moddoio/moddoMOUSE-PCB/Images/Pinout/PCB.png

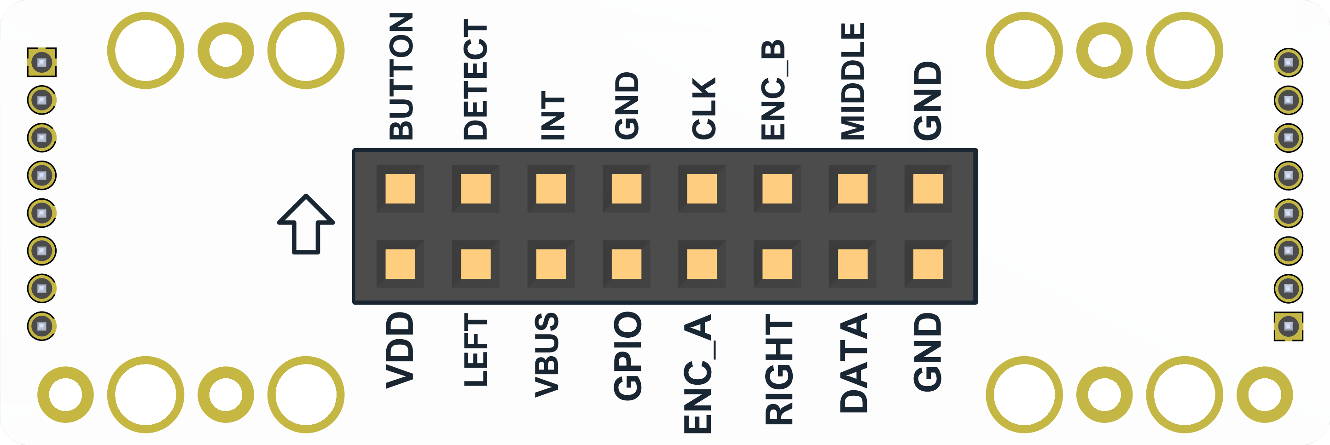
Images/Pinout/PCB.png
