moddoio/moddoMOUSE-PCB/Back_Breakout/Release/PCBA/02.BOM/Bill_Of_Materials-BoM.xlsx

Designator | Name | Description | Manufacturer Part Number | Manufacturer | Footprint | Quantity | Fitted | RoHS Status | Supplier Link
J1, J2 | 1.27mm_6pins |  |  |  | 1.27mm_6pins_MaleHeader_RightAngle | 2 | Fitted | Yes
P1 | Header 6X2 | Header, 6-Pin, Dual row | RS2-12-G | Adam Tech | HEADER_2_54_F_2X6 | 1 | Fitted | ROHS3 | https://www.digikey.ca/en/products/detail/adam-tech/RS2-12-G/9832053
