moddoio/moddoMOUSE-PCB/Back_Lite/Release/PCBA/02.BOM/Bill_Of_Materials-BoM.xlsx

Designator | Name | Description | Manufacturer Part Number | Manufacturer | Footprint | Quantity | Fitted | RoHS Status | Supplier Link
J1 | 1.27mm_6pins | Pin Header 6 Position 1.27mm Pitch Single Row Through Hole, Right Angle -40℃~+105℃ | 1271WR-6P | HanElectricity | 1.27mm_6pins_MaleHeader_RightAngle | 1 | Fitted | Yes | https://www.lcsc.com/product-detail/C7470100.html
J2 | 2328702-8 | FFC/FPC Connector, 8 Contact(s), 1 Row(s), Right Angle, Solder Terminal, Natural Insulator | 2328702-8 | TE Connectivity | 2328702-8 | 1 | Fitted | Yes | https://www.digikey.ca/en/products/detail/te-connectivity-amp-connectors/2328702-8/9565576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
