moddoio/moddoMOUSE-PCB/Front_Breakout/Release/PCBA/02.BOM/Bill_Of_Materials-BoM.xlsx

Designator | Name | Description | Manufacturer Part Number | Manufacturer | Footprint | Quantity | Fitted | RoHS Status | Supplier Link
J1, J2 | 1.27mm_8pins |  |  |  | 1.27mm_8pins_MaleHeader | 2 | Fitted | Yes
P1 | Header 8X2 | Header, 8-Pin, Dual row | RS2-16-G | Adam Tech | HEADER_2_54_F_2X8 | 1 | Fitted | Yes | https://www.digikey.ca/en/products/detail/adam-tech/RS2-16-G/9832058
