moddoio/moddoMOUSE-PCB/Front_Default/Release/PCBA/02.BOM/Bill_Of_Materials-BoM(Main).xlsx

Designator | Name | Description | Manufacturer Part Number | Manufacturer | Footprint | Quantity | Fitted | RoHS Status | Supplier Link
C1, C2, C3, C4, C5 | N/A | N/A | N/A | N/A | CAP0603 | 0 | Not Fitted | Yes | N/A
EN1 | EC10E1220501 | Rotary Encoder Mechanical 12 Quadrature (Incremental) Vertical | EC10E1220501 | Alps Alpine | THROUGH_SHAFT_ENCODER_9MM | 1 | Fitted | ROHS3 | https://www.digikey.ca/en/products/detail/alps-alpine/EC10E1220501/21721562
J1, J2 | 1.27mm_8pins | 1.27mm 1.27mm 1A 1 Gold -40℃~+105℃ 8P Phosphor Bronze Through Hole 1x8P Top 4.3mm Square Hole Through Hole,P=1.27mm Female Headers ROHS |  |  | HEADER_MALE_1_27mm_8p_HEIGHT_1mm | 2 | Fitted | Yes
R1, R2, R3, R4, R5 | N/A | N/A | N/A | N/A | RES0603 | 0 | Not Fitted | Yes | N/A
SW1, SW3 | D2F-01F | SWITCH SNAP ACTION SPDT 0.1A 30V | D2F-01F | Omron Electronics Inc-EMC Div | Microswitch | 2 | Fitted | Yes | https://www.digikey.ca/en/products/detail/omron-electronics-inc-emc-div/D2F-01F/83266
SW2 | TS02-66-70-BK-100-SCR-D | Switch Tactile Spst-no 0.05A 12V | TS02-66-70-BK-100-SCR-D | Same Sky | TS02-66-70-BK-100-SCR-D | 1 | Fitted | Yes | https://www.digikey.ca/en/products/detail/same-sky-formerly-cui-devices/TS02-66-70-BK-100-SCR-D/15634293
