moddoio/moddoMOUSE-PCB/Side_Lite/Release/PCBA/02.BOM/Bill_Of_Materials-BoM.xlsx

Designator | Name | Description | Manufacturer Part Number | Manufacturer | Footprint | Quantity | Fitted | RoHS Status | Supplier Link
J1 | 2328702-8 | FFC/FPC Connector, 8 Contact(s), 1 Row(s), Right Angle, Solder Terminal, Natural Insulator | 2328702-8 | TE Connectivity | 2328702-8 | 1 | Fitted | Yes | https://www.lcsc.com/product-detail/C3168593.html?s_z=n_2328702-8
SW1, SW2 | D2F-01F | SWITCH SNAP ACTION SPDT 0.1A 30V | D2F-01F | Omron Electronics Inc-EMC Div | Microswitch | 2 | Fitted
