moddoio/moddoMOUSE-PCB/Back_Expansion/Back_Expansion_Base/Release/PCBA/02.BOM/Bill_Of_Materials-BoM(Main).xlsx

Designator | Name | Description | Manufacturer Part Number | Manufacturer | Footprint | Quantity | Fitted | RoHS Status | Supplier Link
C1, C4, C6, C7, C8 | 10uF | 25V 10uF X5R ±10% 0603 Multilayer Ceramic Capacitors MLCC - SMD/SMT ROHS | GRM188R61E106KA73D | Murata | C0603 | 5 | Fitted | Yes | https://www.digikey.ca/en/products/detail/murata-electronics/GRM188R61E106KA73D/9867922
C2, C3, C5, C9, C10 | 0.1uF | 25V 100nF X7R ±10% 0402 Multilayer Ceramic Capacitors MLCC - SMD/SMT ROHS | CL05B104KA5NNNC | Samsung Electro-Mechanics | C0402 | 5 | Fitted | Yes | https://www.digikey.ca/en/products/detail/samsung-electro-mechanics/CL05B104KA5NNNC/5961204
D1 | MMDL770T1G | Schottky Barrier Diode, 2-Pin SOD-323, Pb-Free, Tape and Reel | MMDL770T1G | On Semiconductor | ONSC-SOD-323-2-477-02_V | 1 | Fitted | Yes | https://www.digikey.ca/en/products/detail/onsemi/MMDL770T1G/1482073
D2 | LTST-C191KGKT | Single Color LED, Ultra Bright Green, Water Clear, 1.1mm | LTST-C191KGKT | Lite-On | LED0603_G | 1 | Fitted | Yes | https://www.digikey.ca/en/products/detail/liteon/LTST-C191KGKT/386835
J1 | 12402012E212A | USB Connector, USB Type C, USB 2.0, Receptacle, 24 Ways, Surface Mount, Through Hole Mount | 12402012E212A | Amphenol | 12402012E212A | 1 | Fitted | Yes | https://www.digikey.ca/en/products/detail/amphenol-cs-commercial-products/12402012E212A/13683192
J2, J3 | 1271WR-6P | Pin Header 6 Position 1.27mm Pitch Single Row Through Hole, Right Angle -40℃~+105℃ | 1271WR-6P | HanElectricity | 1.27mm_6pins_MaleHeader_RightAngle | 2 | Fitted | Yes | https://www.lcsc.com/product-detail/C7470100.html
J4, J5, J6, J7, J8 | 2328702-8 | FFC/FPC Connector, 8 Contact(s), 1 Row(s), Right Angle, Solder Terminal, Natural Insulator | 2328702-8 | TE Connectivity | 2328702-8 | 5 | Fitted | Yes | https://www.digikey.ca/en/products/detail/te-connectivity-amp-connectors/2328702-8/9565576
LED1 | B38G3RGB-10D0003H2U1930 | Led Rgb Mixed White ( 1.6(L)X1.6 | B38G3RGB-10D0003H2U1930 | Inolux | B38G3RGB-10D0003H2U1930 | 1 | Fitted | Yes | https://www.digikey.ca/en/products/detail/harvatek-corporation/B38G3RGB-10D0003H2U1930/13588733
P1 | Header 5 | Header, 5-Pin | N/A | N/A | HDR1X5 | 0 | Not Fitted | N/A | N/A
P2, P4 | Header 4 | Header, 4-Pin | N/A | N/A | HDR1X4 | 0 | Not Fitted | N/A | N/A
P3 | Header 3X2 | Header, 3-Pin, Dual row | N/A | N/A | HDR2X3 | 0 | Not Fitted | N/A | N/A
Q1, Q2 | SSM6N35AFE,LF | Small Low ON Resistance MOSFET Array Dual N-Channel 20V 250mA 6-Pin SOT-563 T/R | SSM6N35AFE,LF | Toshiba | SSM6N35AFE,LF | 2 | Fitted | Yes | https://www.digikey.ca/en/products/detail/toshiba-semiconductor-and-storage/SSM6N35AFE-LF/7669724
Q3 | IRLML6402TRPBF | MOSFET P-CH 20V 3.7A SOT-23 | IRLML6402TRPBF | Infineon | IRLML6402TRPBF | 1 | Fitted | Yes | https://www.digikey.ca/en/products/detail/infineon-technologies/IRLML6402TRPBF/811437
R1, R2 | 5.1kR | 62.5mW Thick Film Resistors 50V ±100ppm/℃ ±1% 5.1kΩ 0402 Chip Resistor - Surface Mount ROHS | RC0402FR-075K1L | Yageo Group | R0402 | 2 | Fitted | Yes | https://www.digikey.ca/en/products/detail/yageo/RC0402FR-075K1L/726624
R3 | 390R | Res Thick Film 1206 390 Ohm 1% 0.75W(3/4W) ±100ppm/°C Pad SMD Automotive T/R | CRCW1206390RFKEAHP | Vishay | R1206 | 1 | Fitted | Yes | https://www.digikey.ca/en/products/detail/vishay-dale/CRCW1206390RFKEAHP/2227707
R4 | 33R | Res Thick Film Array 33 Ohm 5% 200ppm/ C ISOL Molded 8-Pin 1206(4 X 0603) Convex SMD Paper T/R | YC164-JR-0733RL | Yageo | YC164-JR-0733RL | 1 | Fitted | Yes | https://www.digikey.ca/en/products/detail/yageo/YC164-JR-0733RL/1005086
R5 | 115kR | 62.5mW Thick Film Resistors 50V ±100ppm/℃ ±1% 115kΩ 0402 Chip Resistor - Surface Mount ROHS | RC0402FR-07115KL | Yageo Group | R0402 | 0 | Not Fitted | Yes | https://www.digikey.ca/en/products/detail/yageo/RC0402FR-07115KL/5280816
SW1 | B3U-1100P | SWITCH TACTILE SPST-NO 0.05A 12V | B3U-1100P | Omron Electronics Inc-EMC Div | FP-B3U-1100P-MFG | 1 | Fitted | Yes | https://www.digikey.ca/en/products/detail/omron-electronics-inc-emc-div/B3U-1100P/1534339
U1 | ESDR0502NMUTBG | Ultra Low Capacitance ESD Protection Array for High Speed Data Line Protection, 6-Pin UDFN, Pb-Free, Tape and Reel | ESDR0502NMUTBG | On Semiconductor | ESDR0502NMUTBG | 1 | Fitted | Yes | https://www.digikey.ca/en/products/detail/onsemi/ESDR0502NMUTBG/2271457
U2 | TPS7A2030PDBVR | 300-mA, ultra-low-noise, low-IQ, low-dropout (LDO) linear regulator with high PSRR 5-SOT-23 -40 to 125 | TPS7A2030PDBVR | Texas Instruments | TPS7A2030PDBVR | 1 | Fitted | Yes | https://www.digikey.ca/en/products/detail/texas-instruments/TPS7A2030PDBVR/13566871
U3 | ATSAMD21G18A-MU | MCU 32-Bit SAM D21 ARM Cortex M0+ RISC 256KB Flash 3.3V 48-Pin QFN EP - Trays | ATSAMD21G18A-MU | Microchip | FP-C04-21493-MFG | 1 | Fitted | Yes | https://www.digikey.ca/en/products/detail/microchip-technology/ATSAMD21G18A-MU/4935894
