moddoio/moddoMOUSE-PCB/Back_Expansion/Back_Expansion_Joystick_14p_25_5mm_20_3mm/Release/PCBA/02.BOM/Bill_Of_Materials-BoM.xlsx

Designator | Name | Description | Manufacturer Part Number | Manufacturer | Footprint | Quantity | Fitted | RoHS Status | Supplier Link
J1 | 2328702-8 | FFC/FPC Connector, 8 Contact(s), 1 Row(s), Right Angle, Solder Terminal, Natural Insulator | 2328702-8 | TE Connectivity | 2328702-8 | 1 | Fitted | Yes | https://www.digikey.ca/en/products/detail/te-connectivity-amp-connectors/2328702-8/9565576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
SW1 | YK16S-L7.2-B10Ka(32-8)-G-A29 | Through Hole-14P,25.5x20.3mm Navigation Switches, Joystick RoHS | YK16S-L7.2-B10Ka(32-8)-G-A29 | YTL | Joystick_14p_25_5mm_20_3mm | 1 | Fitted | Yes | https://www.lcsc.com/product-detail/C37323746.html
