moddoio/moddoMOUSE-PCB/Back_Expansion/Back_Expansion_Joystick_8p_16_5mm_15_5mm/Release/PCBA/02.BOM/Bill_Of_Materials-BoM.xlsx

Designator | Name | Description | Manufacturer Part Number | Manufacturer | Footprint | Quantity | Fitted | RoHS Status | Supplier Link
J1 | 2328702-8 | FFC/FPC Connector, 8 Contact(s), 1 Row(s), Right Angle, Solder Terminal, Natural Insulator | 2328702-8 | TE Connectivity | 2328702-8 | 1 | Fitted | Yes | https://www.digikey.ca/en/products/detail/te-connectivity-amp-connectors/2328702-8/9565576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
SW1 | YHE-YG16-001 SH1B166A1 | Through Hole Navigation Switches, Joystick RoHS | YHE-YG16-001 SH1B166A1 | YTL | Joystick_8p_16_5mm_15_5mm | 1 | Fitted | Yes | https://www.lcsc.com/product-detail/C42411044.html
