moddoio/moddoMOUSE-PCB/Back_Expansion/Back_Expansion_Keypad_12/Release/PCBA/02.BOM/Bill_Of_Materials-BoM.xlsx

Designator | Name | Description | Manufacturer Part Number | Manufacturer | Footprint | Quantity | Fitted | RoHS Status | Supplier Link
J1, J2 | 2328702-8 | FFC/FPC Connector, 8 Contact(s), 1 Row(s), Right Angle, Solder Terminal, Natural Insulator | 2328702-8 | TE Connectivity | 2328702-8 | 2 | Fitted | Yes | https://www.digikey.ca/en/products/detail/te-connectivity-amp-connectors/2328702-8/9565576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
SW0, SW1, SW2, SW3, SW4, SW5, SW6, SW7, SW8, SW9, SW10, SW11 | GT-TS090C-H031-L5 | Tactile Switch SPST 100gf 3.1mm SMD (SMT) Tab 6.2mm x 6.2mm Surface Mount | GT-TS090C-H031-L5 | G-Switch | Switch_6_2mm_6_2mm_3_1mm | 12 | Fitted | Yes | https://www.lcsc.com/product-detail/C2686883.html?s_z=n_q_GT-TS090C-H031-L5
