moddoio/moddoMOUSE-PCB/Back_Expansion/Back_Expansion_ScrollWheel/Release/PCBA/02.BOM/Bill_Of_Materials-BoM(Main).xlsx

Designator | Name | Description | Manufacturer Part Number | Manufacturer | Footprint | Quantity | Fitted | RoHS Status | Supplier Link
EN1 | EC10E1220501 | Mechanical Encoder Rotary Incremental Hollow 5mN.m Right Angle Quadrature Digital Square Wave 12PPR Through Hole PC Pin | EC10E1220501 | Alps Electric | THROUGH_SHAFT_ENCODER_9MM | 1 | Fitted | Yes | https://www.digikey.ca/en/products/detail/alps-alpine/EC10E1220501/21721562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
J1 | 2328702-8 | FFC/FPC Connector, 8 Contact(s), 1 Row(s), Right Angle, Solder Terminal, Natural Insulator | 2328702-8 | TE Connectivity | 2328702-8 | 1 | Fitted | Yes | https://www.digikey.ca/en/products/detail/te-connectivity-amp-connectors/2328702-8/9565576
SW1 | TS02-66-70-BK-100-SCR-D | Switch Tactile Spst-no 0.05A 12V | TS02-66-70-BK-100-SCR-D | Same Sky | TS02-66-70-BK-100-SCR-D | 1 | Fitted | Yes | https://www.digikey.ca/en/products/detail/same-sky-formerly-cui-devices/TS02-66-70-BK-100-SCR-D/15634293
