moddoio/moddoMOUSE-PCB/Front_Extended/Front_Extended_Base/Release/PCBA/02.BOM/Bill_Of_Materials-BoM(Main).xlsx

Designator | Name | Description | Manufacturer Part Number | Manufacturer | Footprint | Quantity | Fitted | RoHS Status | Supplier Link
J1, J2 | 1.27mm_8pins | 1.27mm 1.27mm 1A 1 Gold -40℃~+105℃ 8P Phosphor Bronze Through Hole 1x8P Top 4.3mm Square Hole Through Hole,P=1.27mm Female Headers ROHS | N/A | N/A | 1.27mm_8pins_MaleHeader | 2 | Fitted | Yes | N/A
J3 | 2328702-8 | FFC/FPC Connector, 8 Contact(s), 1 Row(s), Right Angle, Solder Terminal, Natural Insulator | 2328702-8 | TE Connectivity | 2328702-8 | 1 | Fitted | Yes | https://www.digikey.ca/en/products/detail/te-connectivity-amp-connectors/2328702-8/9565576
P1 | Header 3 | Header, 3-Pin | N/A | N/A | HDR1X3 | 0 | Not Fitted | N/A | N/A
P2, P3 | Header 3X2 | Header, 3-Pin, Dual row | N/A | N/A | HDR2X3 | 0 | Not Fitted | N/A | N/A
