moddoio/moddoMOUSE-PCB/Front_Lite/Front_Lite_Left/Release/PCBA/02.BOM/Bill_Of_Materials-BoM.xlsx

Designator | Name | Description | Manufacturer Part Number | Manufacturer | Footprint | Quantity | Fitted | RoHS Status | Supplier Link
J1 | 1.27mm_8pins | 1.27mm 1.27mm 1A 1 Gold -40℃~+105℃ 8P Phosphor Bronze Through Hole 1x8P Top 4.3mm Square Hole Through Hole,P=1.27mm Female Headers ROHS |  |  | HEADER_MALE_1_27mm_8p_HEIGHT_1mm | 1 | Fitted | Yes
SW1 | D2F-01F | SWITCH SNAP ACTION SPDT 0.1A 30V | D2F-01F | Omron Electronics Inc-EMC Div | Microswitch | 1 | Fitted | Yes | https://www.digikey.ca/en/products/detail/omron-electronics-inc-emc-div/D2F-01F/83266
