moddoio/moddoMOUSE-PCB/Back_Expansion/Back_Expansion_Base/Release/Mechanical/PCB(Main).step

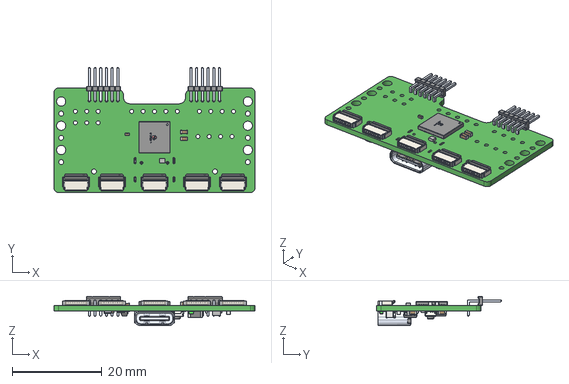
[picture p2: CAD file, 2026-05-08]
Back_Expansion/Back_Expansion_Base/Release/Mechanical/PCB(Main).step
44.8 x 27.9 x 6.51 mm
