moddoio/moddoMOUSE-PCB/Back_Expansion/Back_Expansion_Breakout/Release/Mechanical/PCB(Main).step

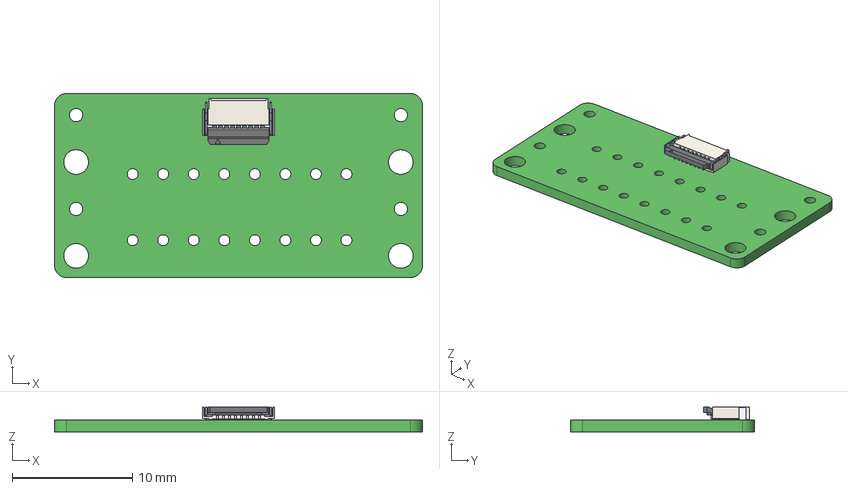
[picture p3: CAD file, 2026-05-08]
Back_Expansion/Back_Expansion_Breakout/Release/Mechanical/PCB(Main).step
30.6 x 15.3 x 2.06 mm
