moddoio/moddoMOUSE-PCB/Back_Expansion/Back_Expansion_ScrollWheel/Release/Mechanical/PCB(Main).step

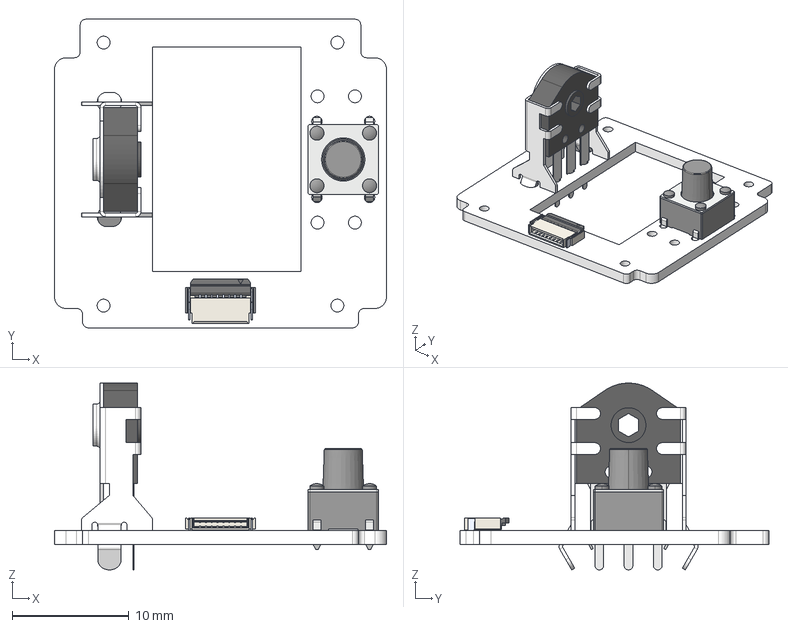
[picture p4: CAD file, 2026-05-08]
Back_Expansion/Back_Expansion_ScrollWheel/Release/Mechanical/PCB(Main).step
28.4 x 26.4 x 16.0 mm
