moddoio/moddoMOUSE-PCB/Front_Extended/Front_Extended_Base/Release/Mechanical/PCB(Main).step

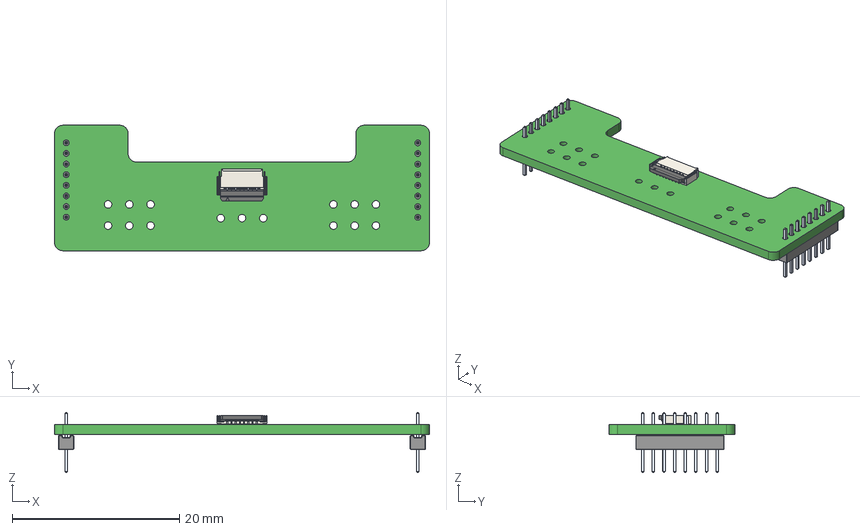
[picture p5: CAD file, 2026-04-28]
Front_Extended/Front_Extended_Base/Release/Mechanical/PCB(Main).step
44.8 x 15.0 x 7.20 mm
