moddoio/moddoMOUSE-PCB/Front_Extended/Front_Extended_Front/Release/Mechanical/PCB(Main).step

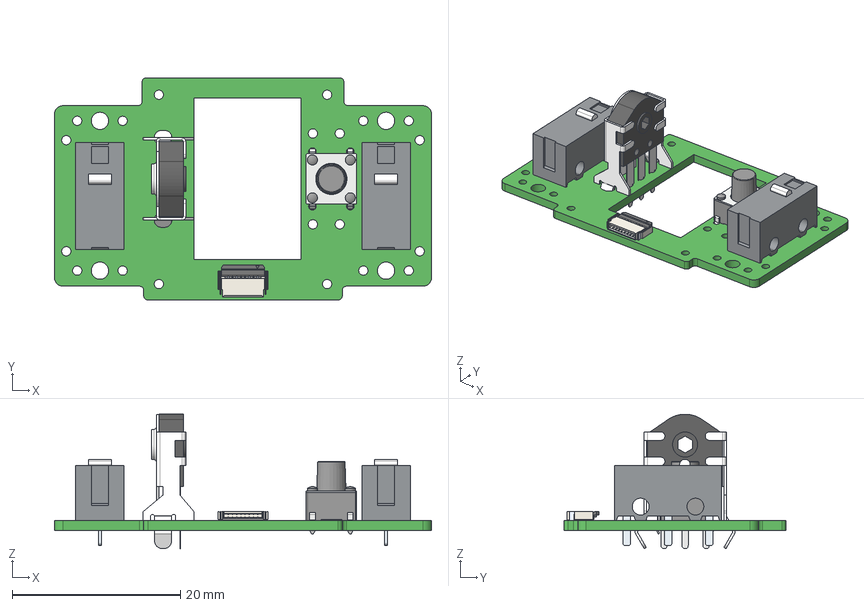
[picture p6: CAD file, 2026-05-08]
Front_Extended/Front_Extended_Front/Release/Mechanical/PCB(Main).step
44.8 x 26.4 x 16.0 mm
