moddoio/moddoMOUSE-PCB/Back_Breakout/Release/Mechanical/PCB.step

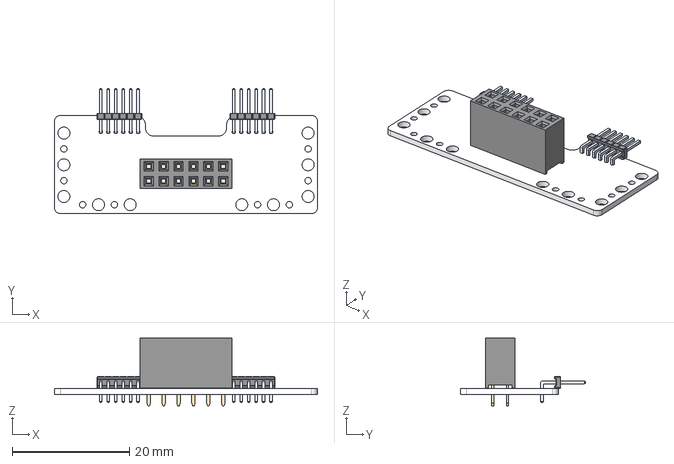
[picture p7: CAD file, 2026-04-21]
Back_Breakout/Release/Mechanical/PCB.step
44.8 x 21.3 x 11.5 mm
