moddoio/moddoMOUSE-PCB/Back_Expansion/Back_Expansion_Joystick_14p_25_5mm_20_3mm/Release/Mechanical/PCB.step

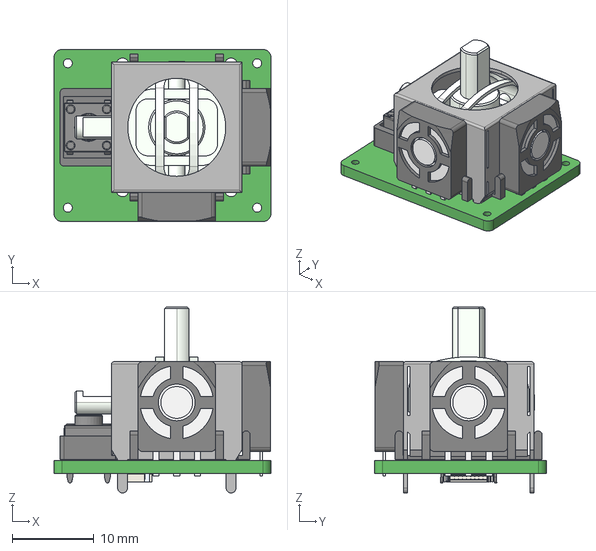
[picture p8: CAD file, 2026-05-08]
Back_Expansion/Back_Expansion_Joystick_14p_25_5mm_20_3mm/Release/Mechanical/PCB.step
26.6 x 21.1 x 22.8 mm
