moddoio/moddoMOUSE-PCB/Back_Expansion/Back_Expansion_Joystick_8p_16_5mm_15_5mm/Release/Mechanical/PCB.step

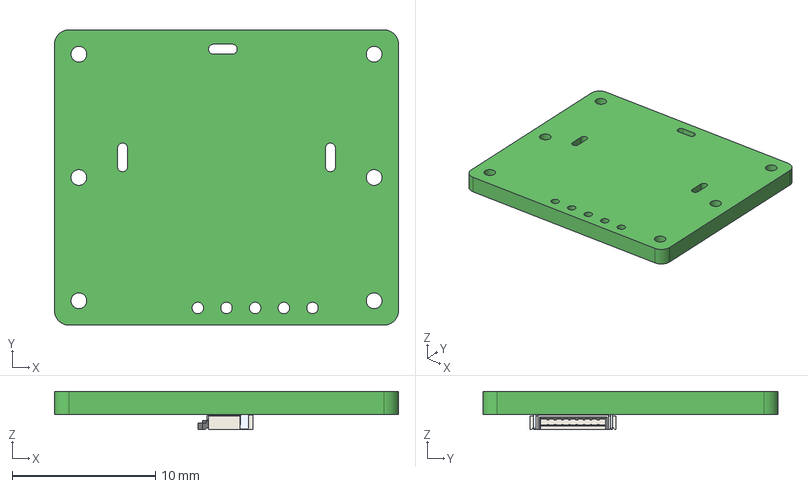
[picture p9: CAD file, 2026-05-08]
Back_Expansion/Back_Expansion_Joystick_8p_16_5mm_15_5mm/Release/Mechanical/PCB.step
24.0 x 20.6 x 2.66 mm
