moddoio/moddoMOUSE-PCB/Back_Expansion/Back_Expansion_Keypad_12/Release/Mechanical/PCB.step

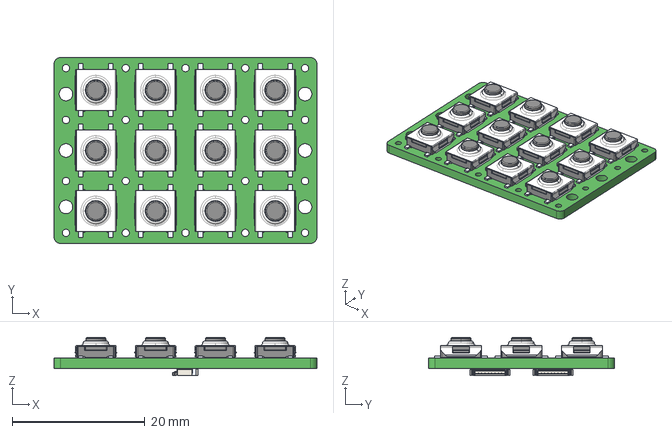
[picture p10: CAD file, 2026-05-08]
Back_Expansion/Back_Expansion_Keypad_12/Release/Mechanical/PCB.step
39.6 x 28.0 x 5.77 mm
