moddoio/moddoMOUSE-PCB/Back_Expansion/Back_Expansion_Keypad_6/Release/Mechanical/PCB.step

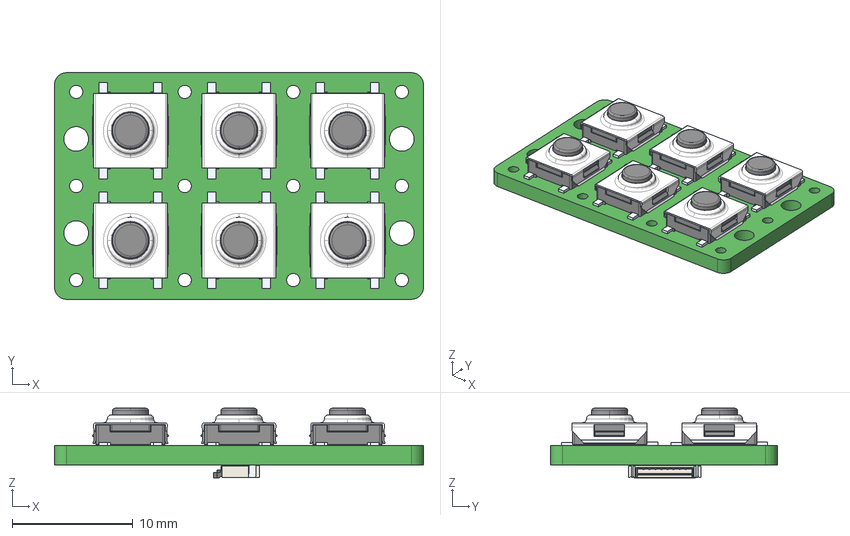
[picture p11: CAD file, 2026-05-08]
Back_Expansion/Back_Expansion_Keypad_6/Release/Mechanical/PCB.step
30.6 x 18.8 x 5.77 mm
