moddoio/moddoMOUSE-PCB/Back_Lite/Release/Mechanical/PCB.step

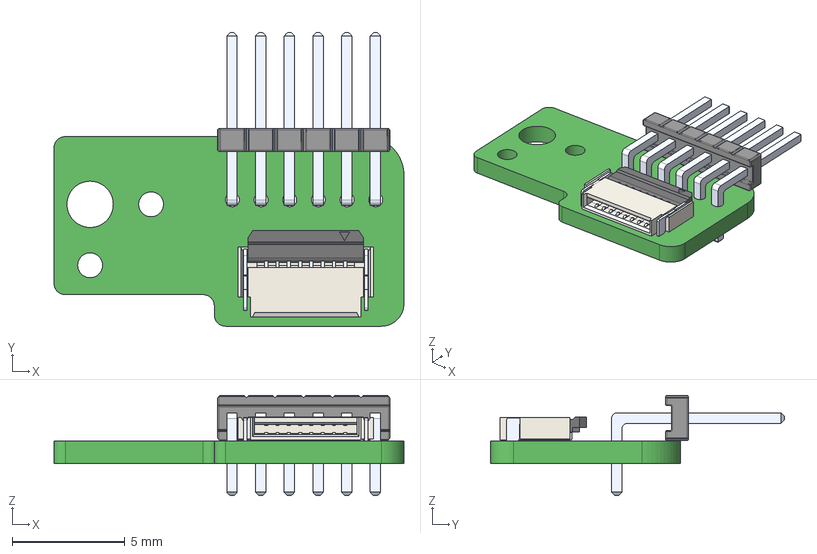
[picture p12: CAD file, 2026-04-21]
Back_Lite/Release/Mechanical/PCB.step
15.5 x 13.0 x 4.43 mm
