moddoio/moddoMOUSE-PCB/Front_Breakout/Release/Mechanical/PCB.step

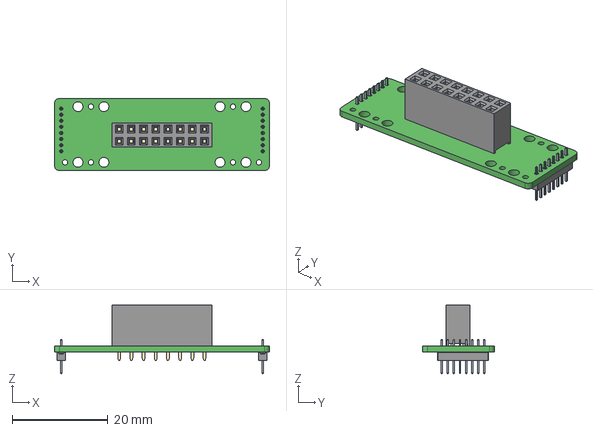
[picture p13: CAD file, 2026-04-21]
Front_Breakout/Release/Mechanical/PCB.step
44.8 x 15.0 x 14.3 mm
