moddoio/moddoMOUSE-PCB/Front_Default/Release/Mechanical/PCB.step

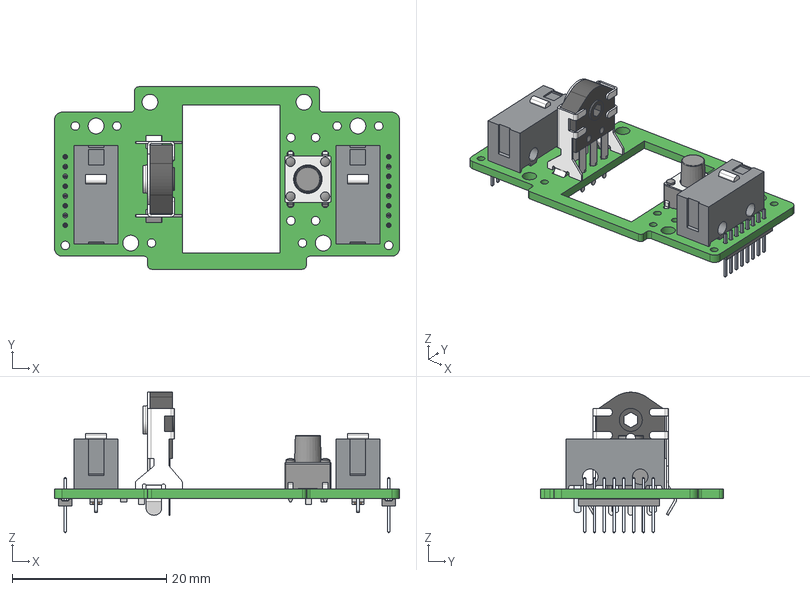
[picture p14: CAD file, 2026-04-21]
Front_Default/Release/Mechanical/PCB.step
44.8 x 23.7 x 18.3 mm
