moddoio/moddoMOUSE-PCB/Front_Lite/Front_Lite_Left/Release/Mechanical/PCB.step

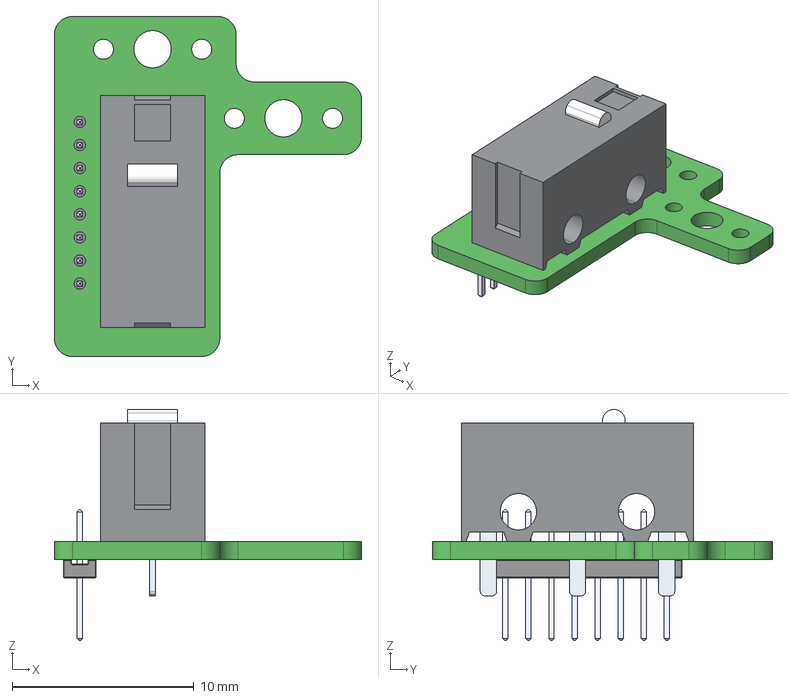
[picture p15: CAD file, 2026-04-21]
Front_Lite/Front_Lite_Left/Release/Mechanical/PCB.step
16.9 x 18.7 x 12.7 mm
