moddoio/moddoMOUSE-PCB/Side_Lite/Release/Mechanical/PCB.step

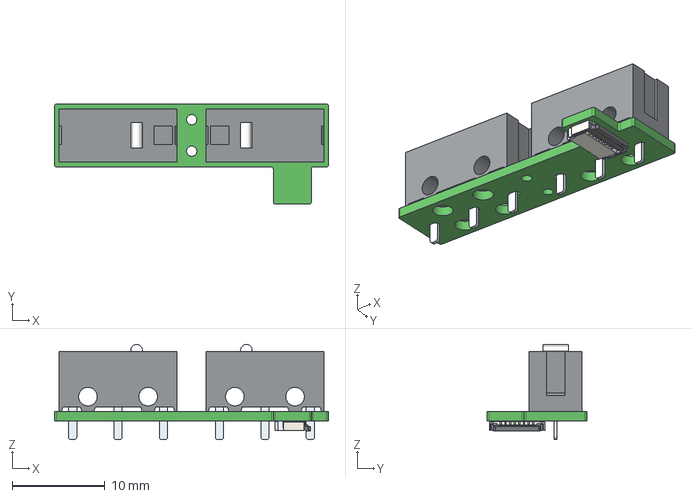
[picture p16: CAD file, 2026-04-21]
Side_Lite/Release/Mechanical/PCB.step
29.6 x 10.8 x 10.2 mm
