moddoio/moddoMOUSE-PCB/(list of files, cad)

Other CAD files:
Front_Lite/Front_Lite_Right/Release/Mechanical/PCB.step
