moddoio/moddoMOUSE-PCB/MainBoard/Rev_B2/MainBoard_Assembly.pdf

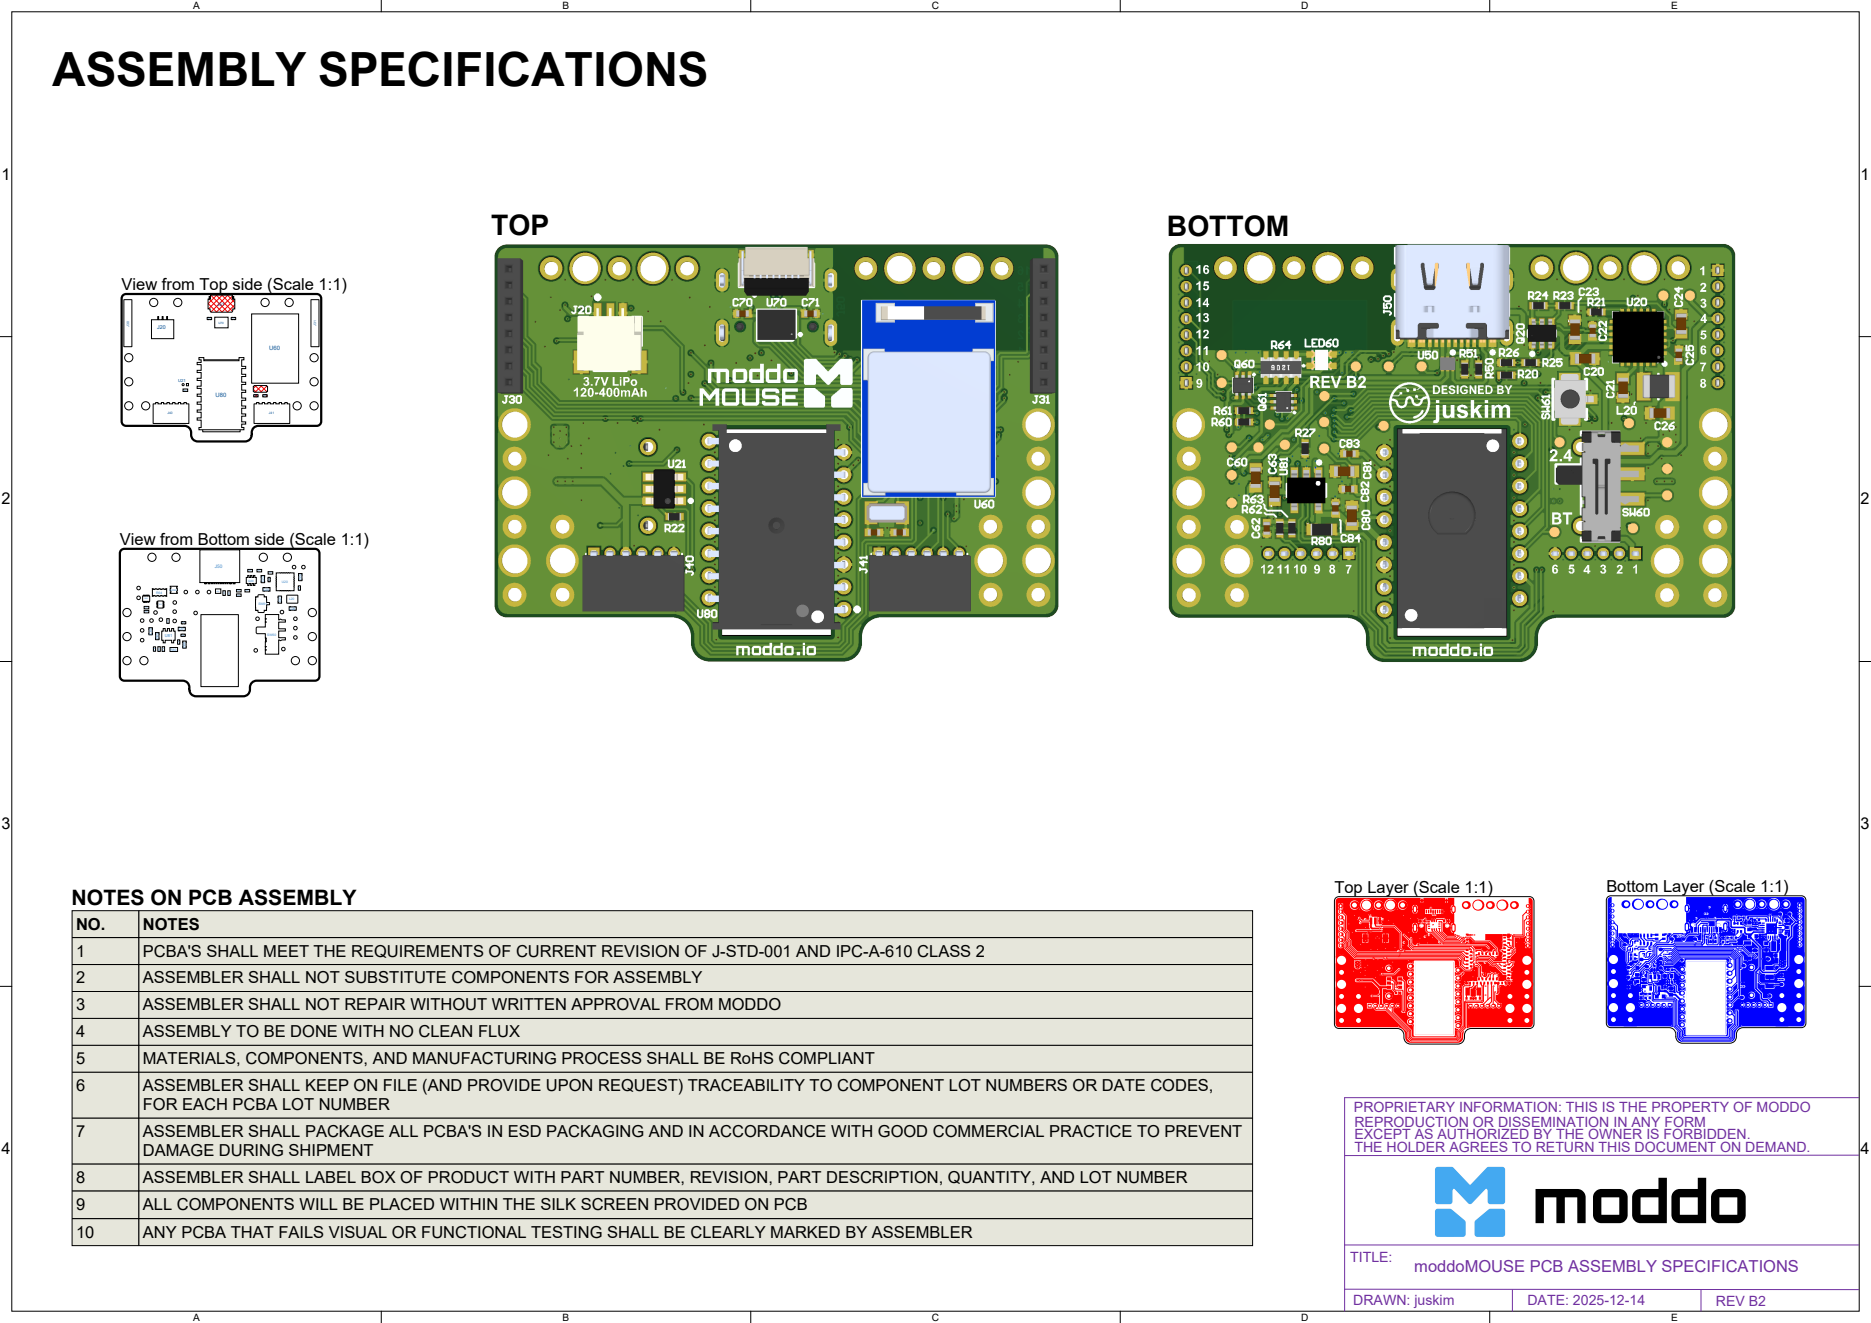
[picture p17: page 1]

View from Top side (Scale 1:1)

View from Bottom side (Scale 1:1)

NOTES ON PCB ASSEMBLY

NO. | NOTES
1 | PCBA'S SHALL MEET THE REQUIREMENTS OF CURRENT REVISION OF J-STD-001 AND IPC-A-610 CLASS 2
2 | ASSEMBLER SHALL NOT SUBSTITUTE COMPONENTS FOR ASSEMBLY
3 | ASSEMBLER SHALL NOT REPAIR WITHOUT WRITTEN APPROVAL FROM MODDO
4 | ASSEMBLY TO BE DONE WITH NO CLEAN FLUX
5 | MATERIALS, COMPONENTS, AND MANUFACTURING PROCESS SHALL BE RoHS COMPLIANT
6 | ASSEMBLER SHALL KEEP ON FILE (AND PROVIDE UPON REQUEST) TRACEABILITY TO COMPONENT LOT NUMBERS OR DATE CODES, FOR EACH PCBA LOT NUMBER

PROPRIETARY INFORMATION: THIS IS THE PROPERTY OF MODDO
REPRODUCTION OR DISSEMINATION IN ANY FORM
EXCEPT AS AUTHORIZED BY THE OWNER IS FORBIDDEN.
THE HOLDER AGREES TO RETURN THIS DOCUMENT ON DEMAND.

7 | ASSEMBLER SHALL PACKAGE ALL PCBA'S IN ESD PACKAGING AND IN ACCORDANCE WITH GOOD COMMERCIAL PRACTICE TO PREVENT DAMAGE DURING SHIPMENT

8 | ASSEMBLER SHALL LABEL BOX OF PRODUCT WITH PART NUMBER, REVISION, PART DESCRIPTION, QUANTITY, AND LOT NUMBER
9 | ALL COMPONENTS WILL BE PLACED WITHIN THE SILK SCREEN PROVIDED ON PCB
10 | ANY PCBA THAT FAILS VISUAL OR FUNCTIONAL TESTING SHALL BE CLEARLY MARKED BY ASSEMBLER

moddoMOUSE PCB ASSEMBLY SPECIFICATIONS

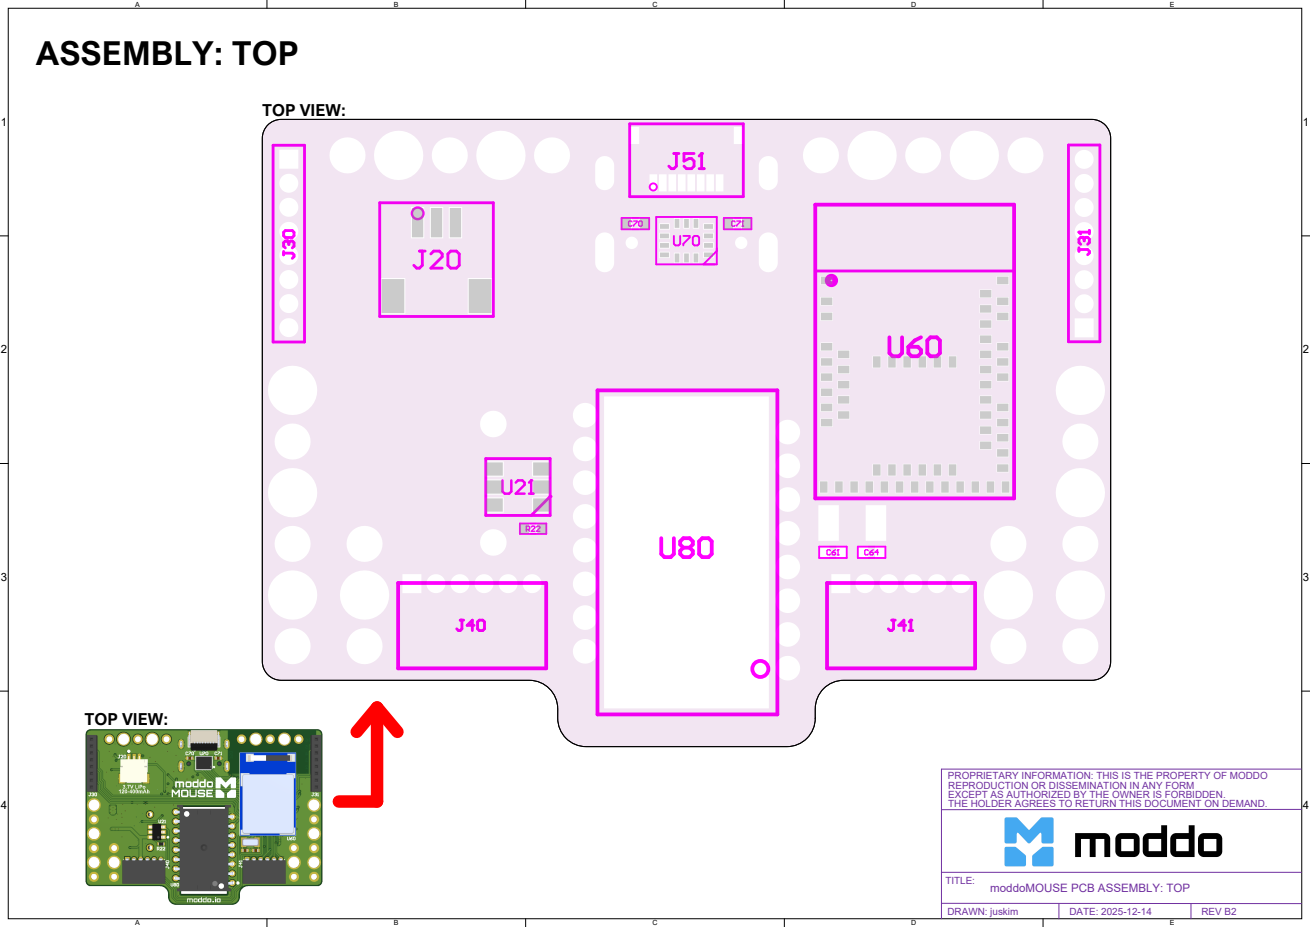
[picture p18: page 2]
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

moddoMOUSE PCB ASSEMBLY: TOP

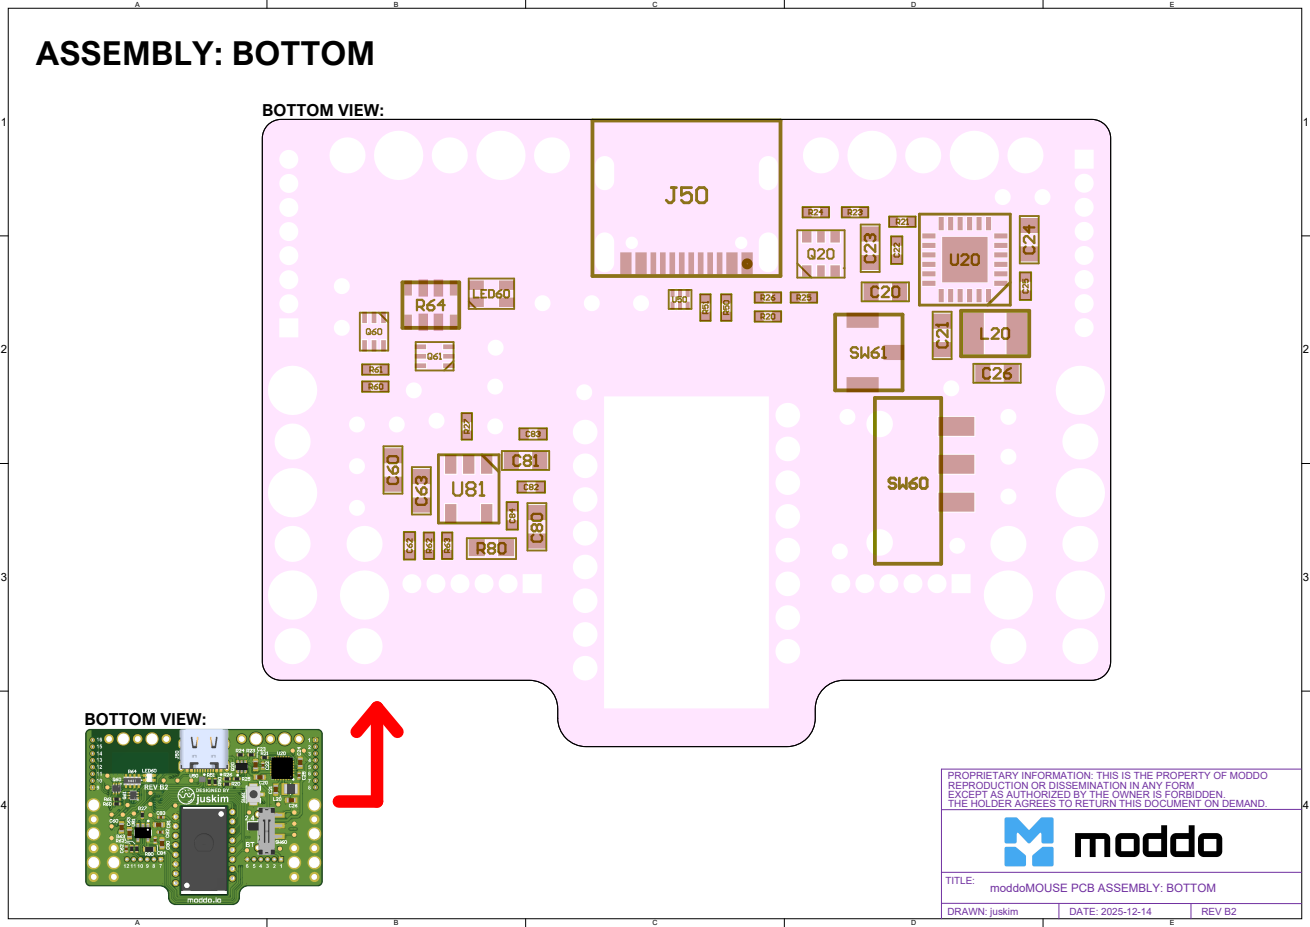
[picture p19: page 3]
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

moddoMOUSE PCB ASSEMBLY: BOTTOM
