moddoio/moddoMOUSE-PCB/MainBoard/Rev_B2/MainBoard_Schematic.pdf

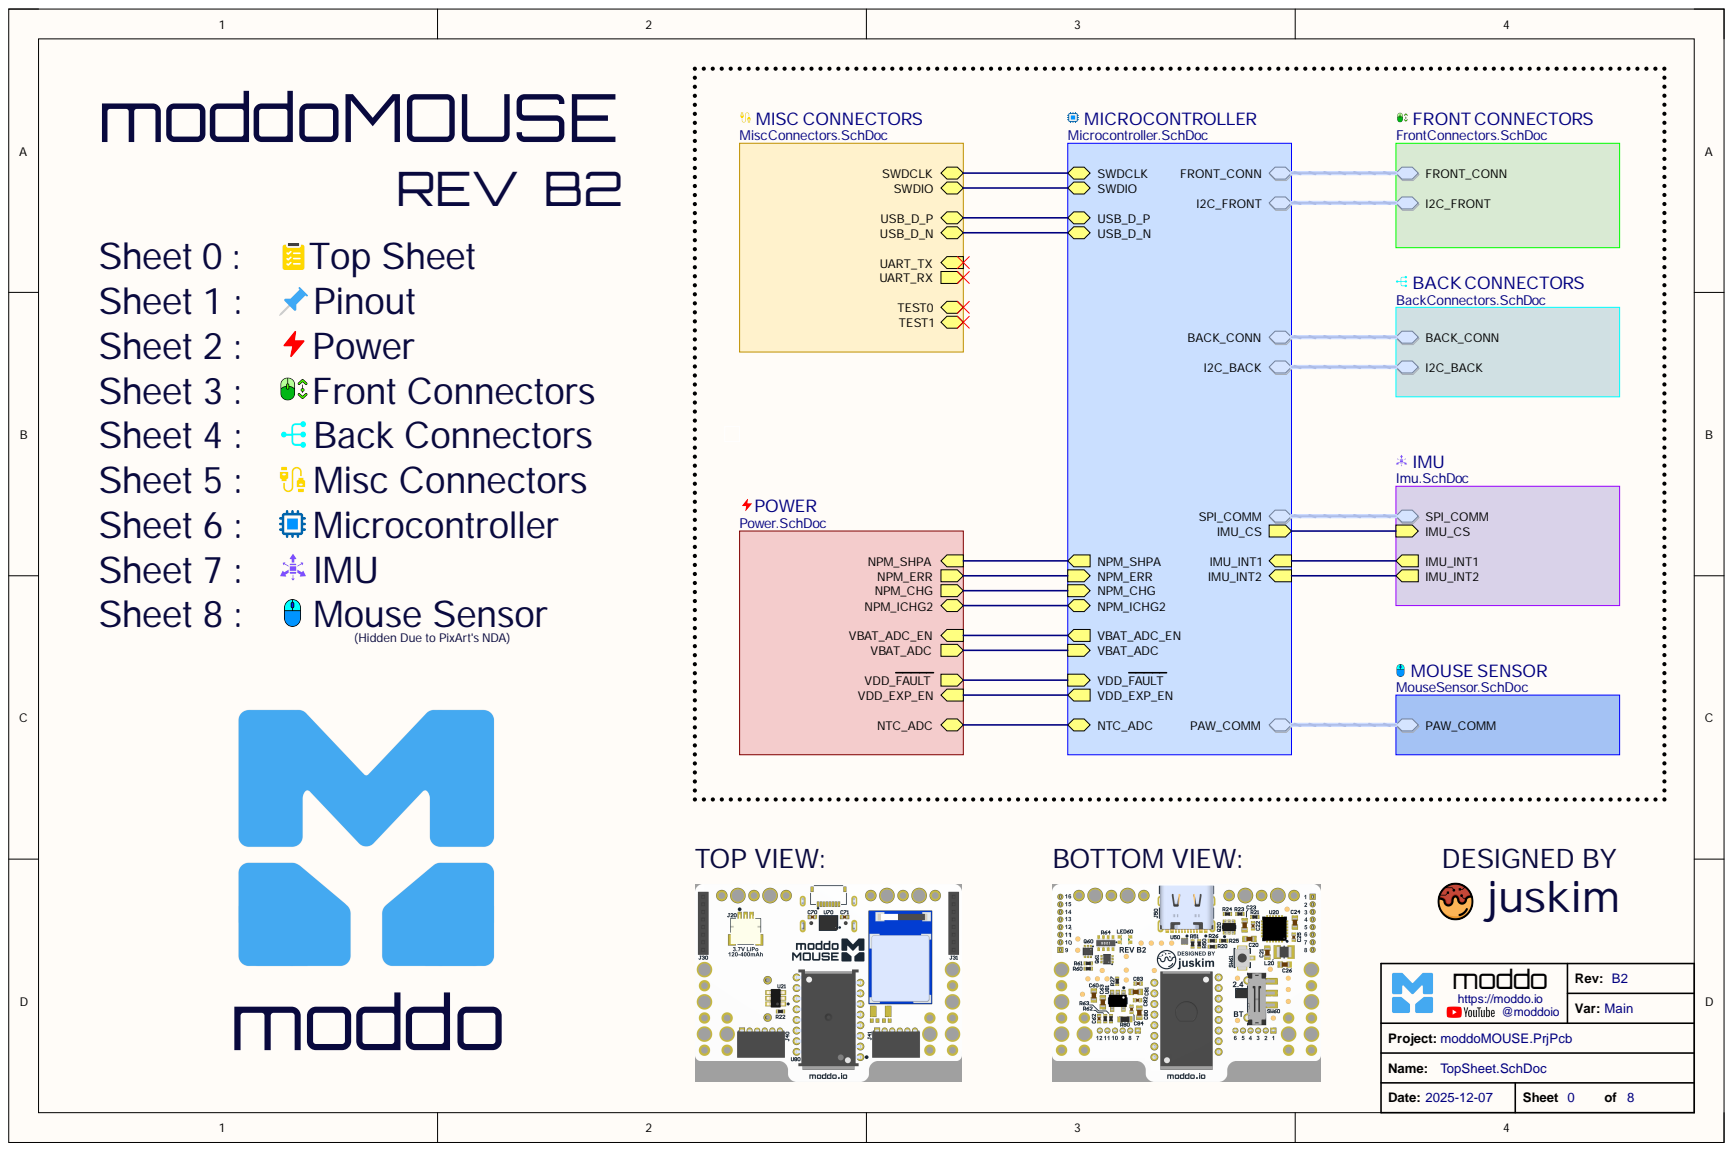
[picture p20: page 1]

FRONT CONNECTORS FrontConnectors.SchDoc

BACK CONNECTORS BackConnectors.SchDoc

(Hidden Due to PixArt's NDA)

MOUSE SENSOR MouseSensor.SchDoc

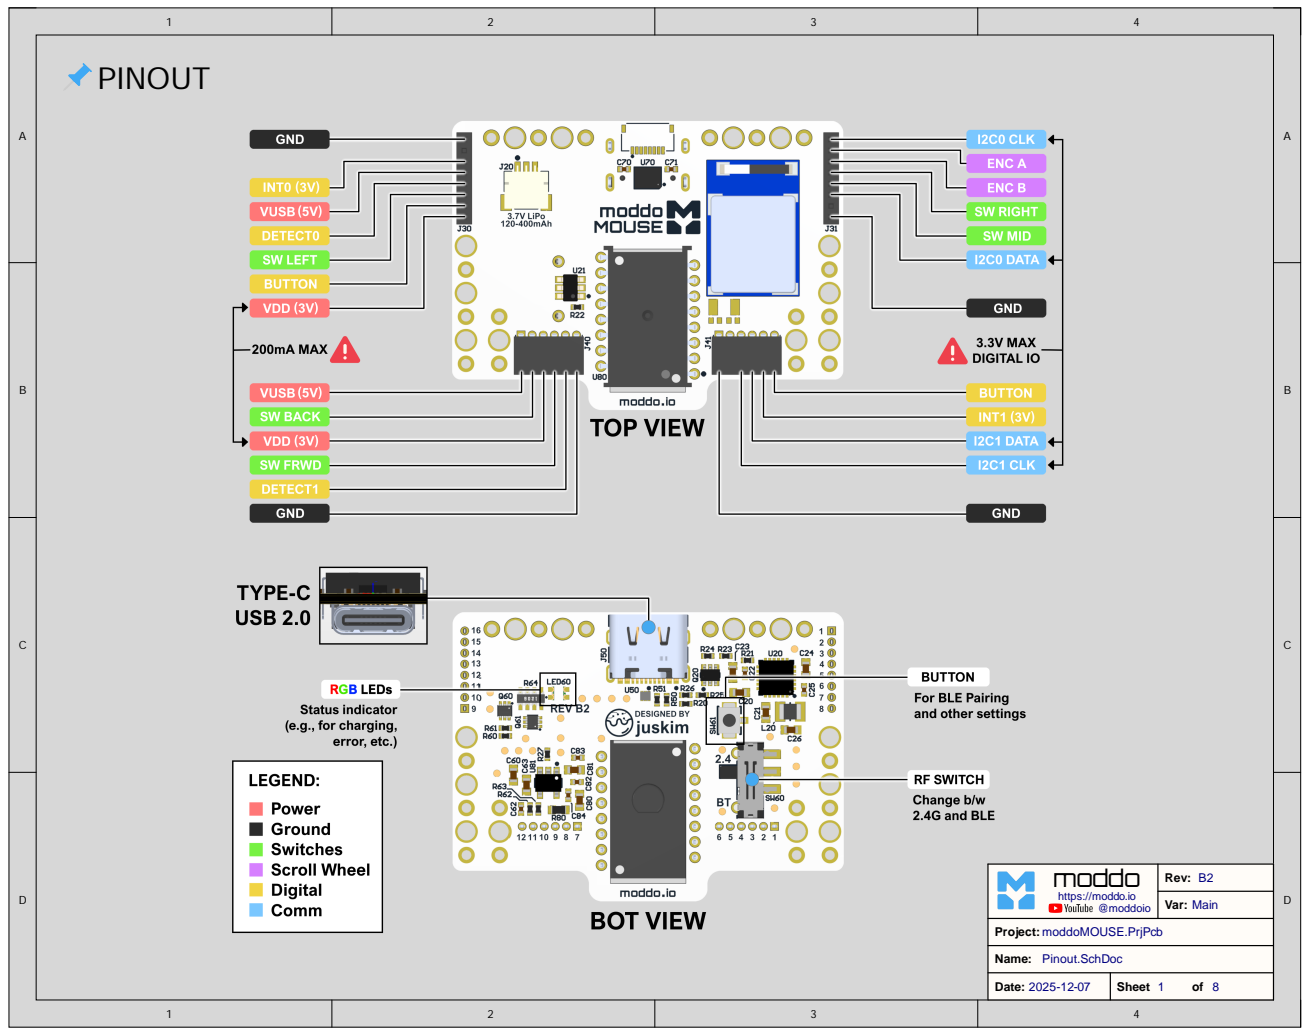
[picture p21: page 2]

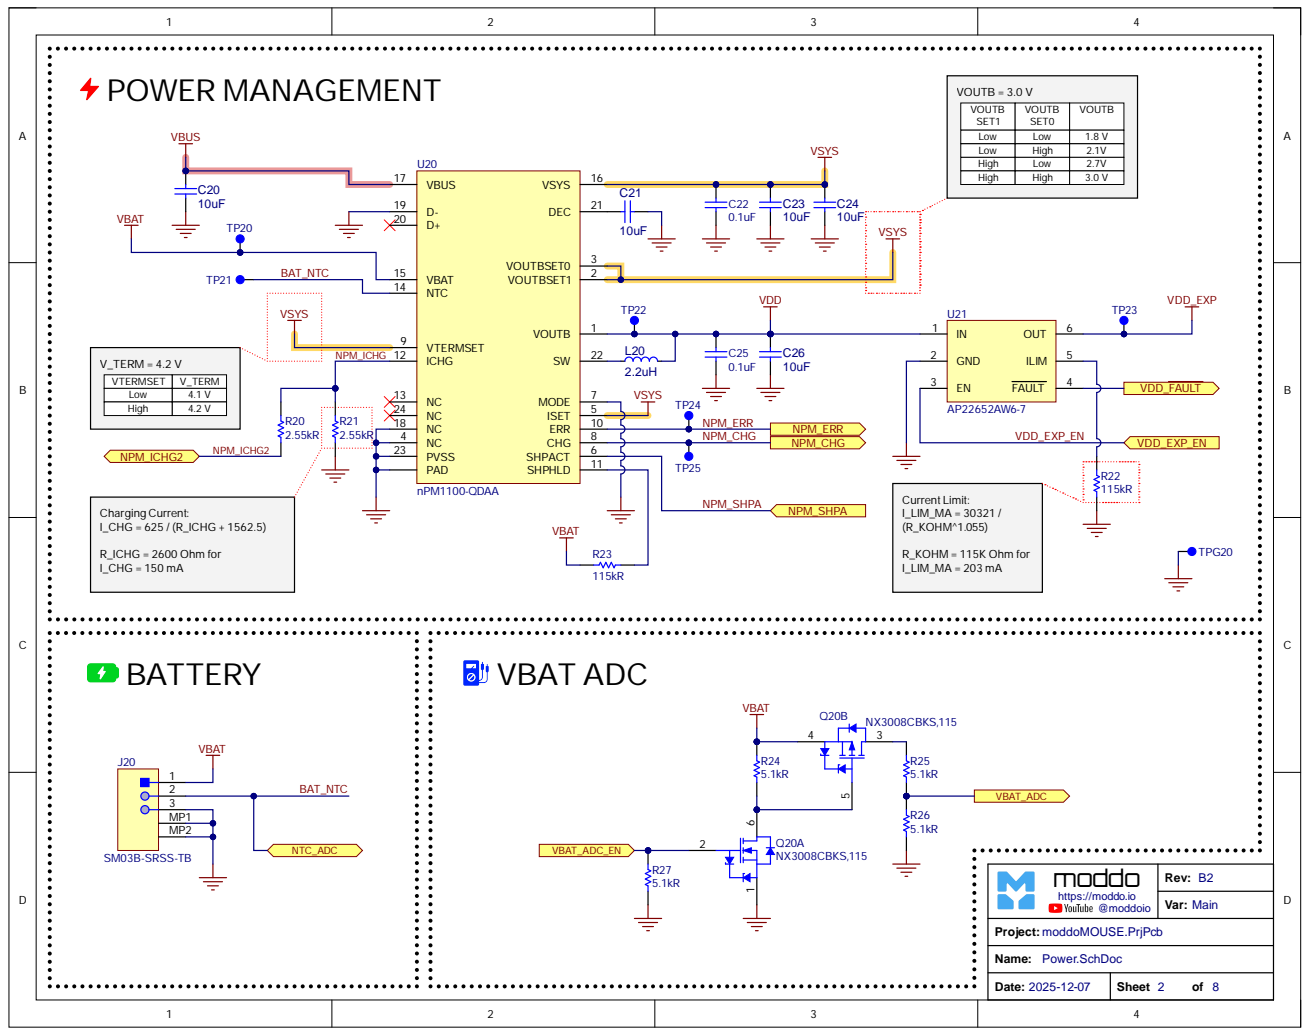
[picture p22: page 3]

VOUTB SET1 | VOUTB SET0 | VOUTB

Low | Low | 1.8 V
Low | High | 2.1V
High | Low | 2.7V
High | High | 3.0 V

GND 2

VTERMSET | V_TERM
Low | 4.1 V

MP1
MP2

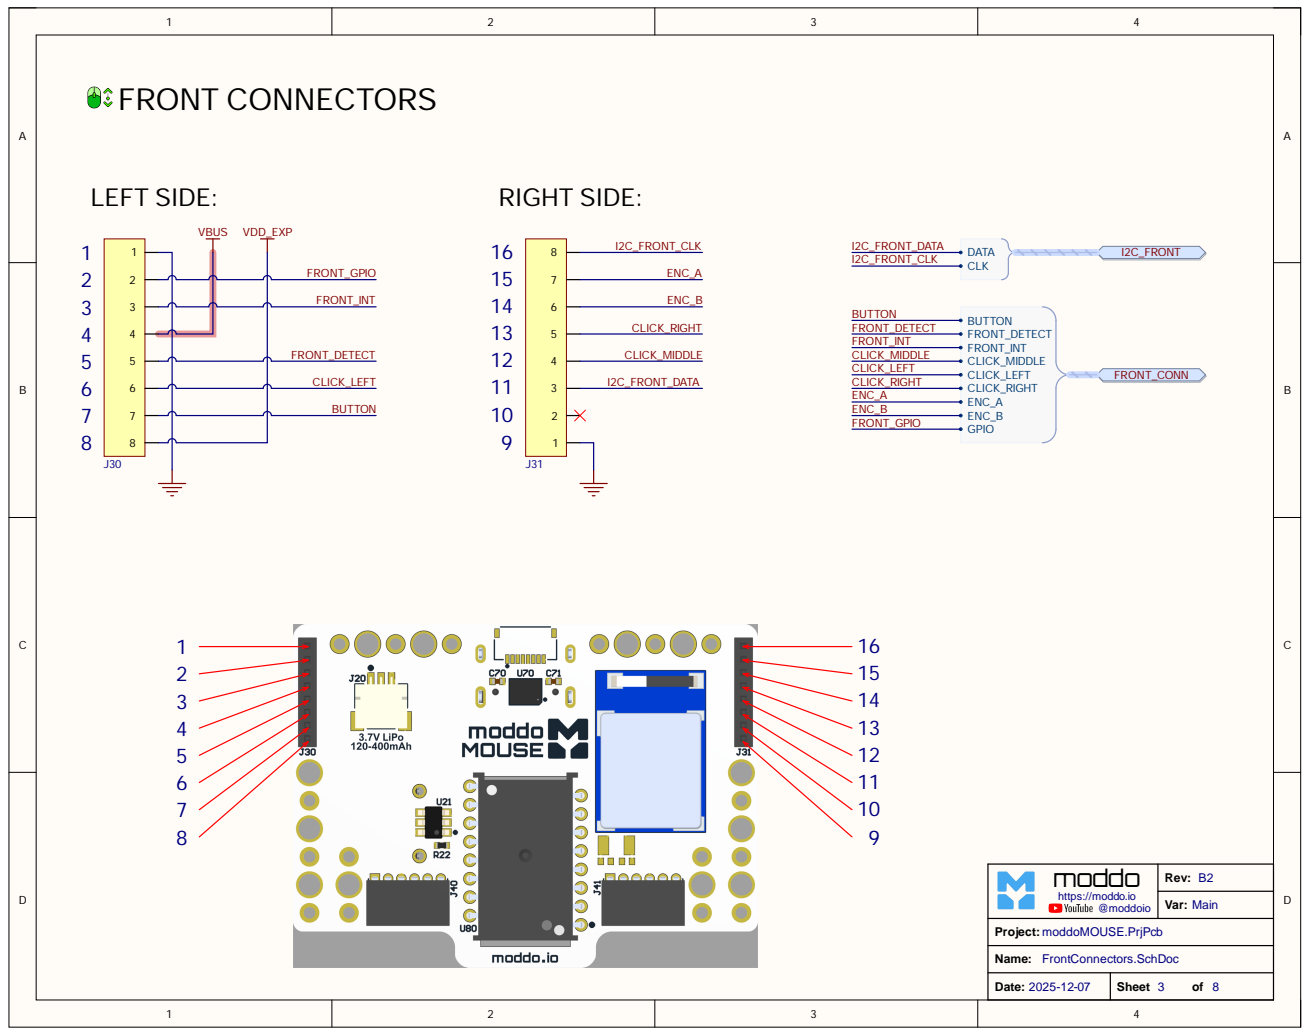
[picture p23: page 4]

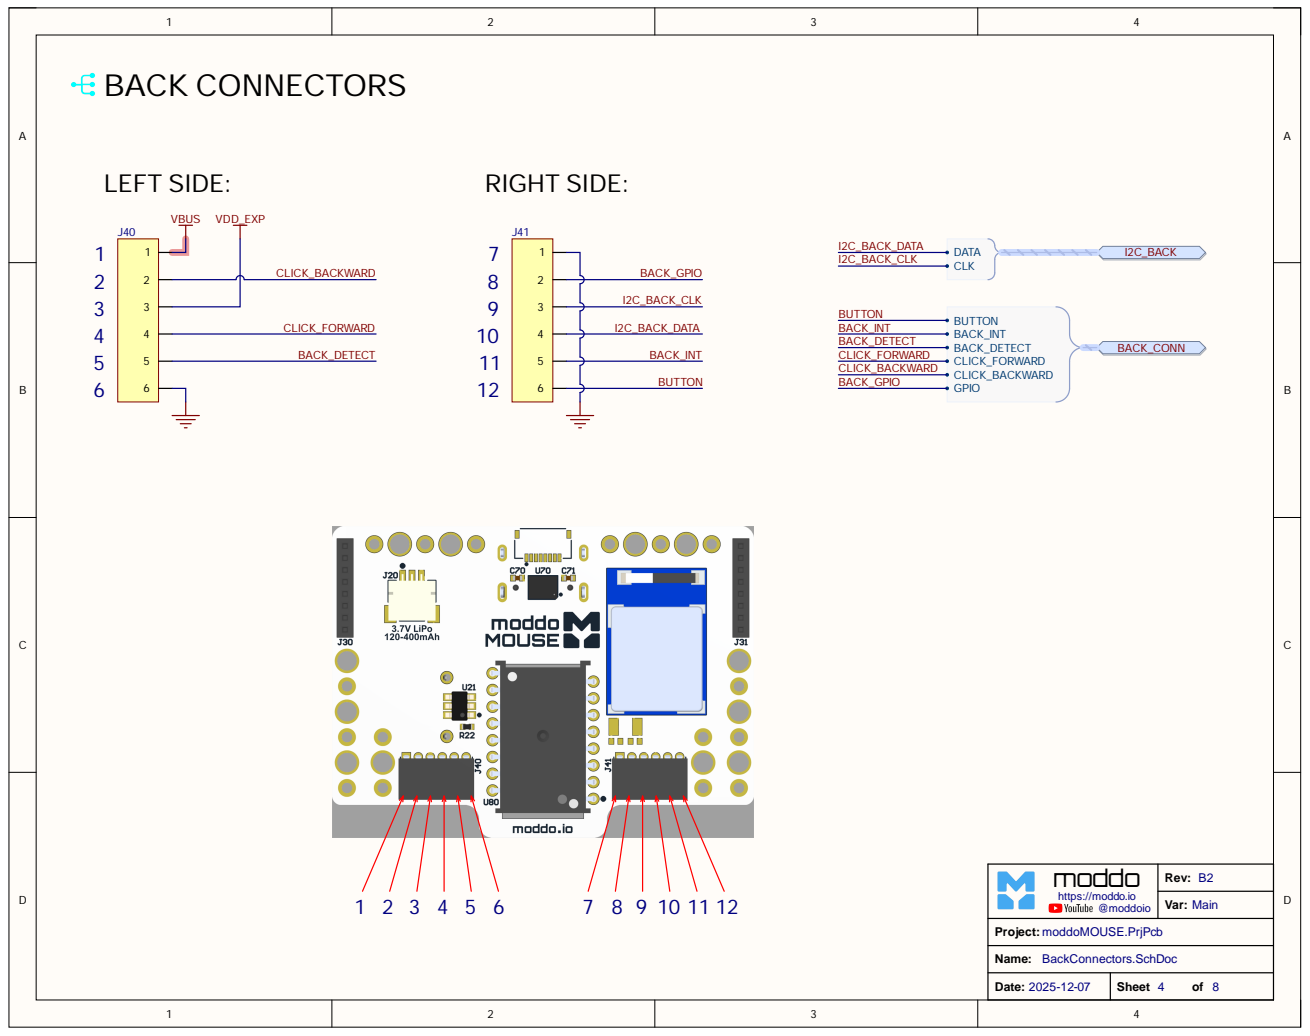
[picture p24: page 5]

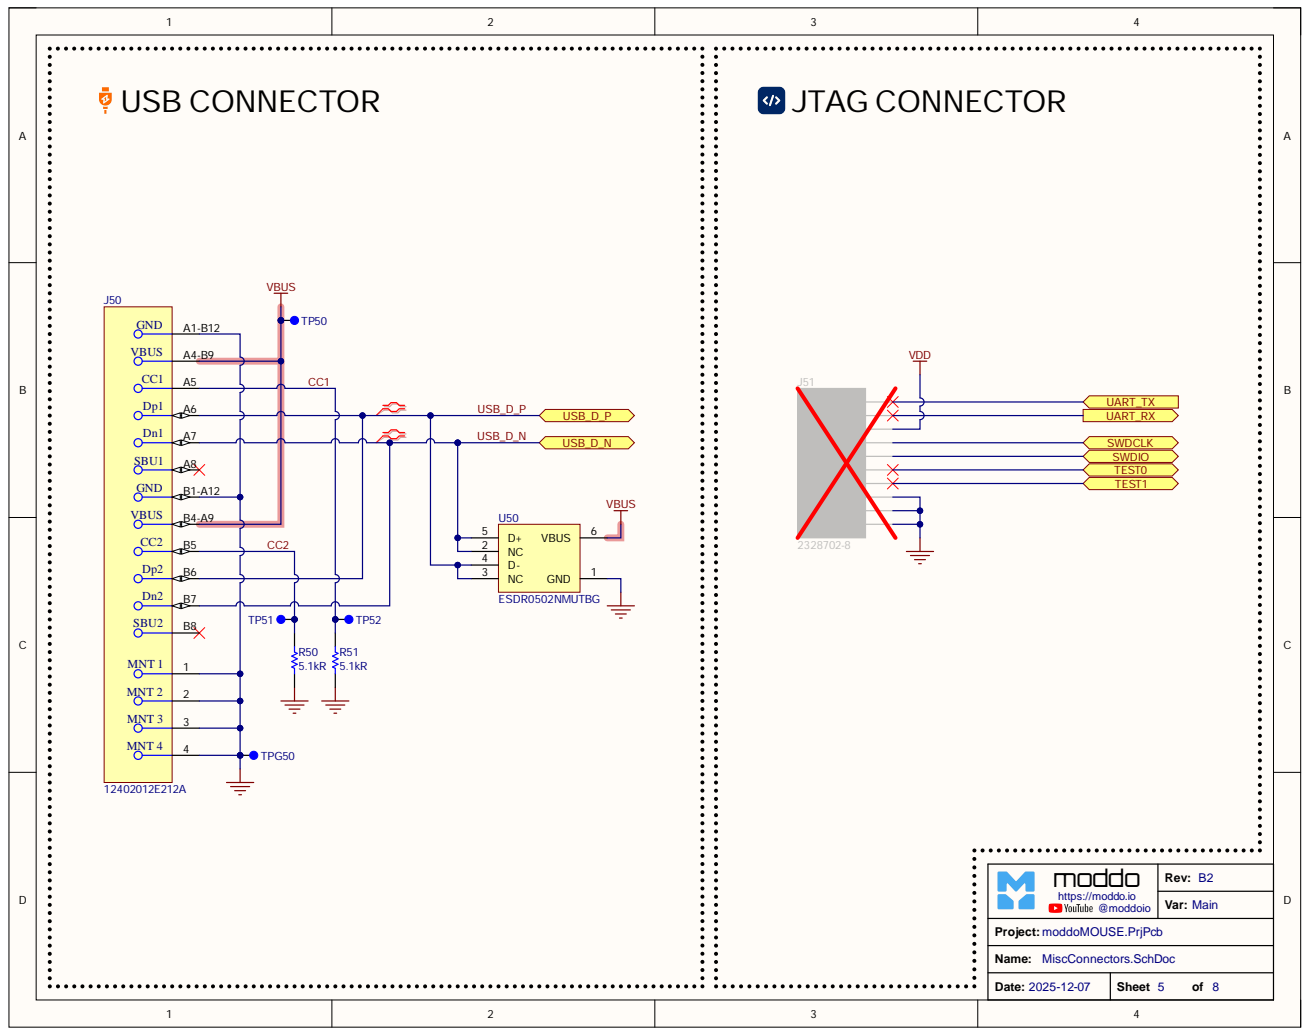
[picture p25: page 6]

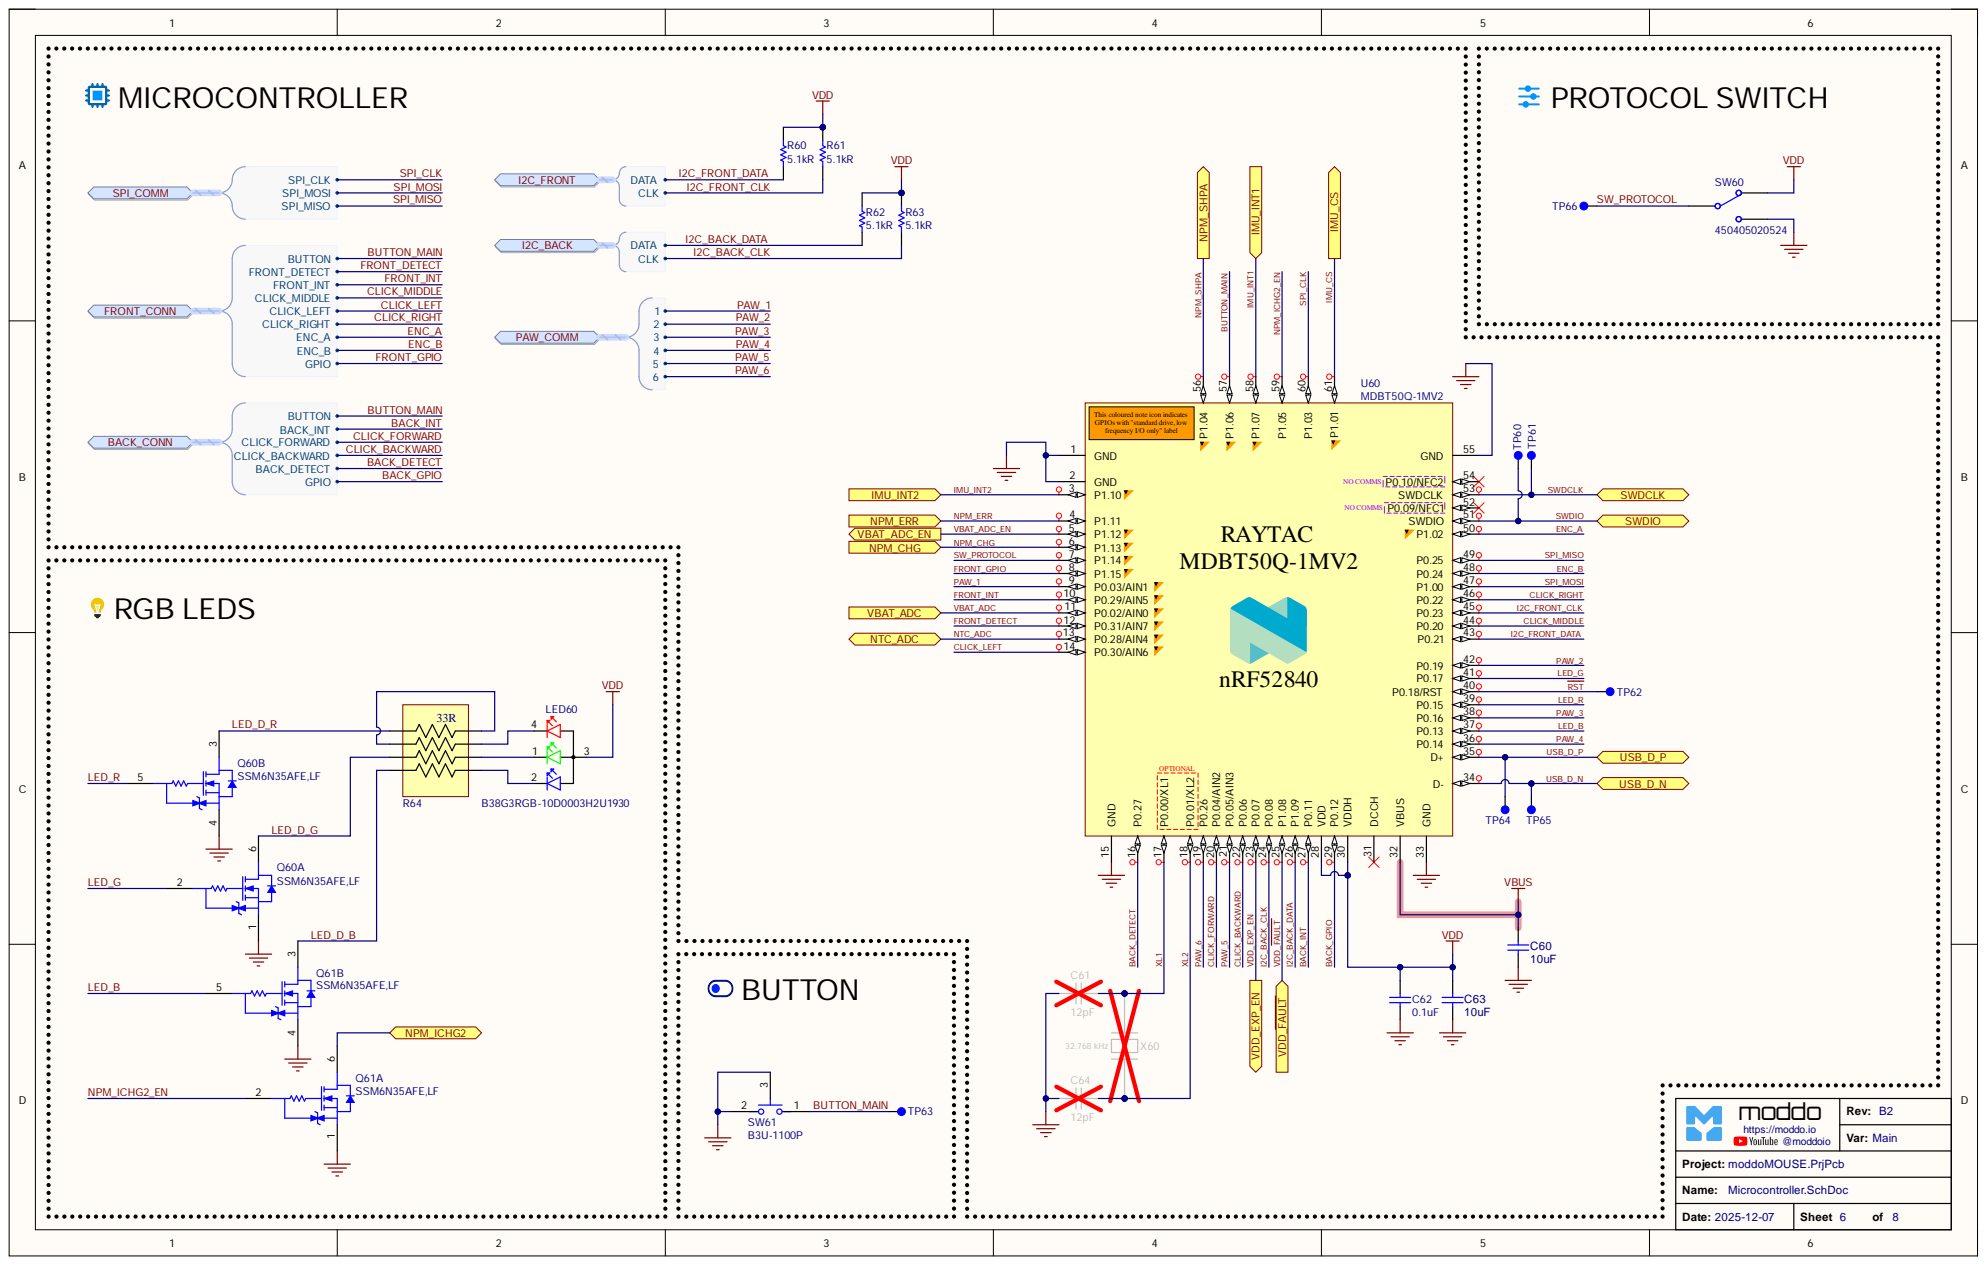
[picture p26: page 7]

This coloured note icon indicates
GPIOs with "standard drive, low
frequency I/O only" label

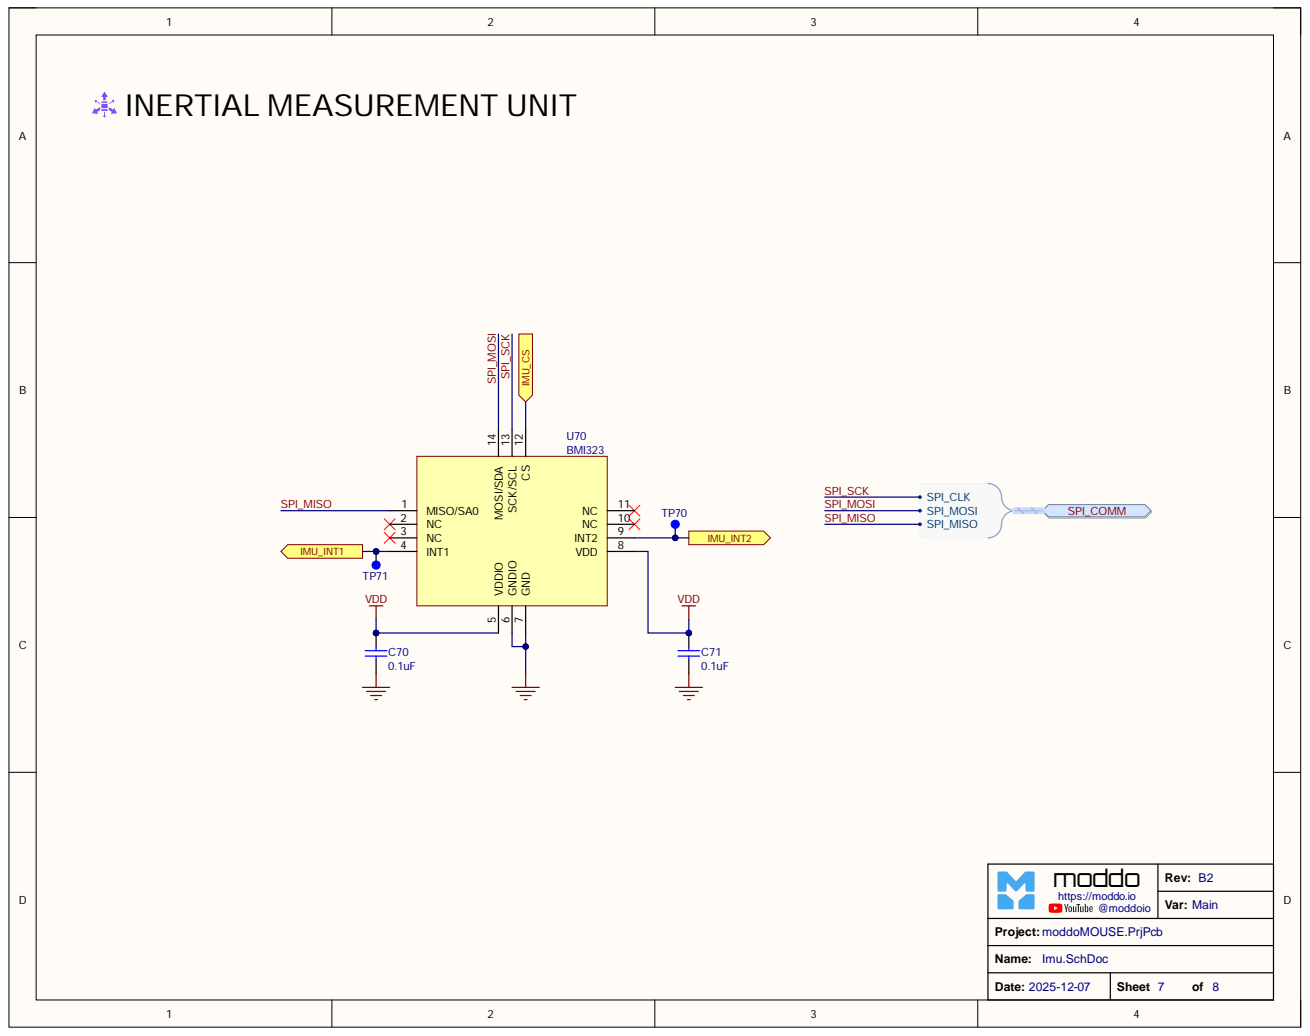
[picture p27: page 8]

GND 7 CS 12 SCK/SCL 13 MOSI/SDA 14
