moddoio/moddoMOUSE-PCB/Back_Expansion/Back_Expansion_Breakout/Release/PCBA/01.SCHEMATICS/Schematics.PDF

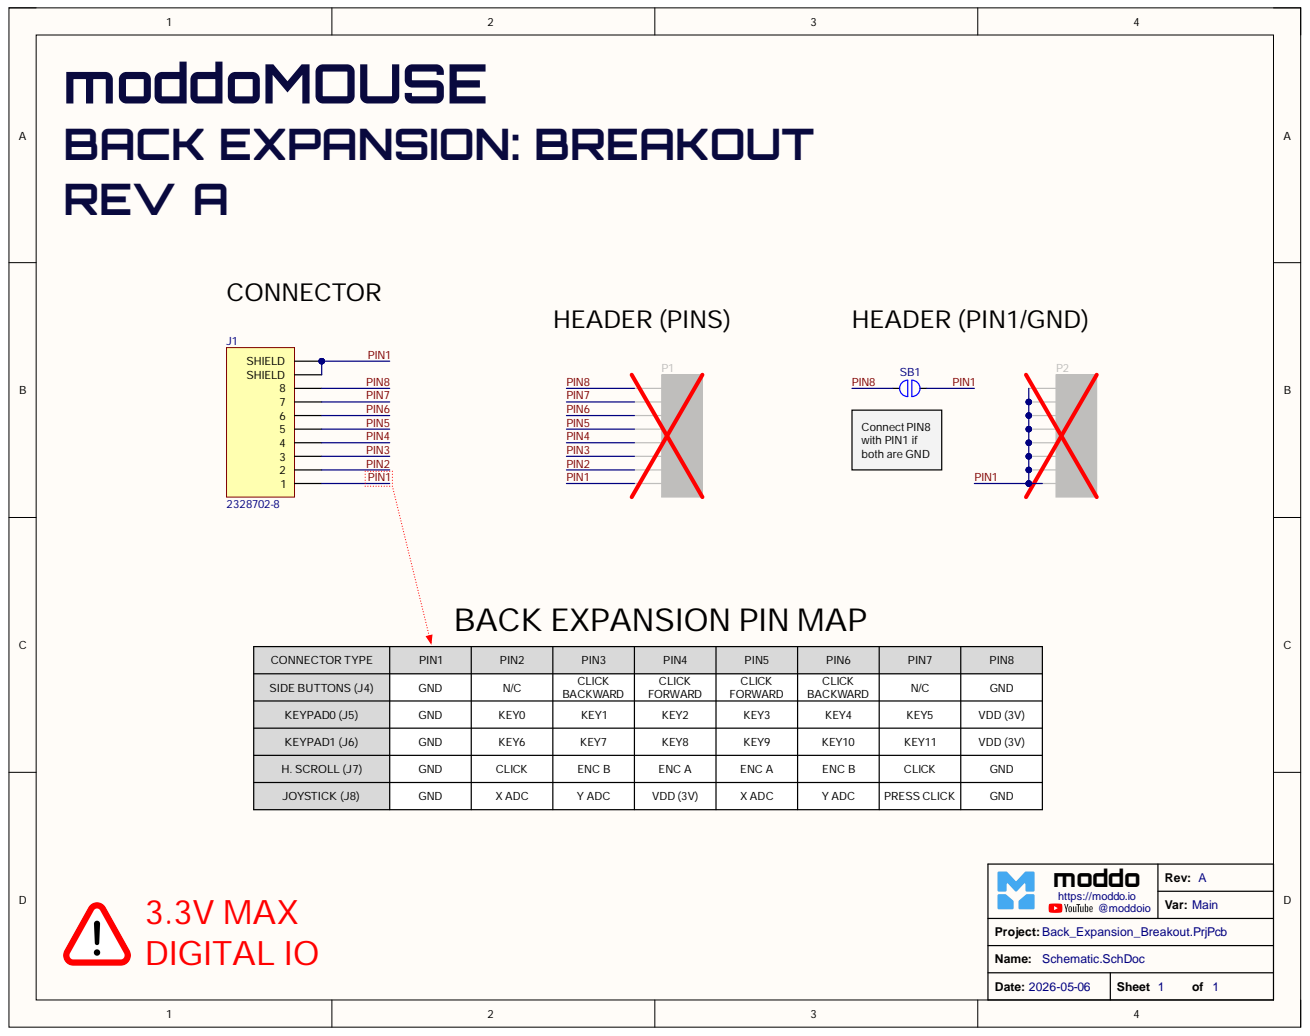
[picture p28: page 1]

CONNEC TOR T Y P E | PIN 1 | PIN 2 | PIN 3 | PIN 4 | PIN 5 | PIN 6 | PIN 7 | PIN 8
(J4) SIDE BUT TONS | D G N | N/C | CL I C K B ACK WA R D | CL I C K FORWA R D | CL I C K FORWA R D | CL I C K B ACK WA R D | N/C | G N D

KEY PAD0 (J5) | G N D | K E Y 0 | K E Y 1 | K E Y 2 | K E Y 3 | K E Y 4 | K E Y 5 | VD D ( 3V)

KEY PAD1 (J6) | G N D | K E Y 6 | K E Y 7 | K E Y 8 | K E Y 9 | K E Y 1 0 | K E Y 1 1 | VD D ( 3V)

H. SCROLL (J7) | G N D | CL I C K | ENC B | ENC A | ENC A | ENC B | CL I C K | G N D

JO Y STICK (J8) | G N D | X A D C | Y A D C | VD D ( 3V) | X A D C | Y A D C | PRE S S CLICK | G N D
