moddoio/moddoMOUSE-PCB/Back_Breakout/Release/PCBA/01.SCHEMATICS/Schematics.PDF

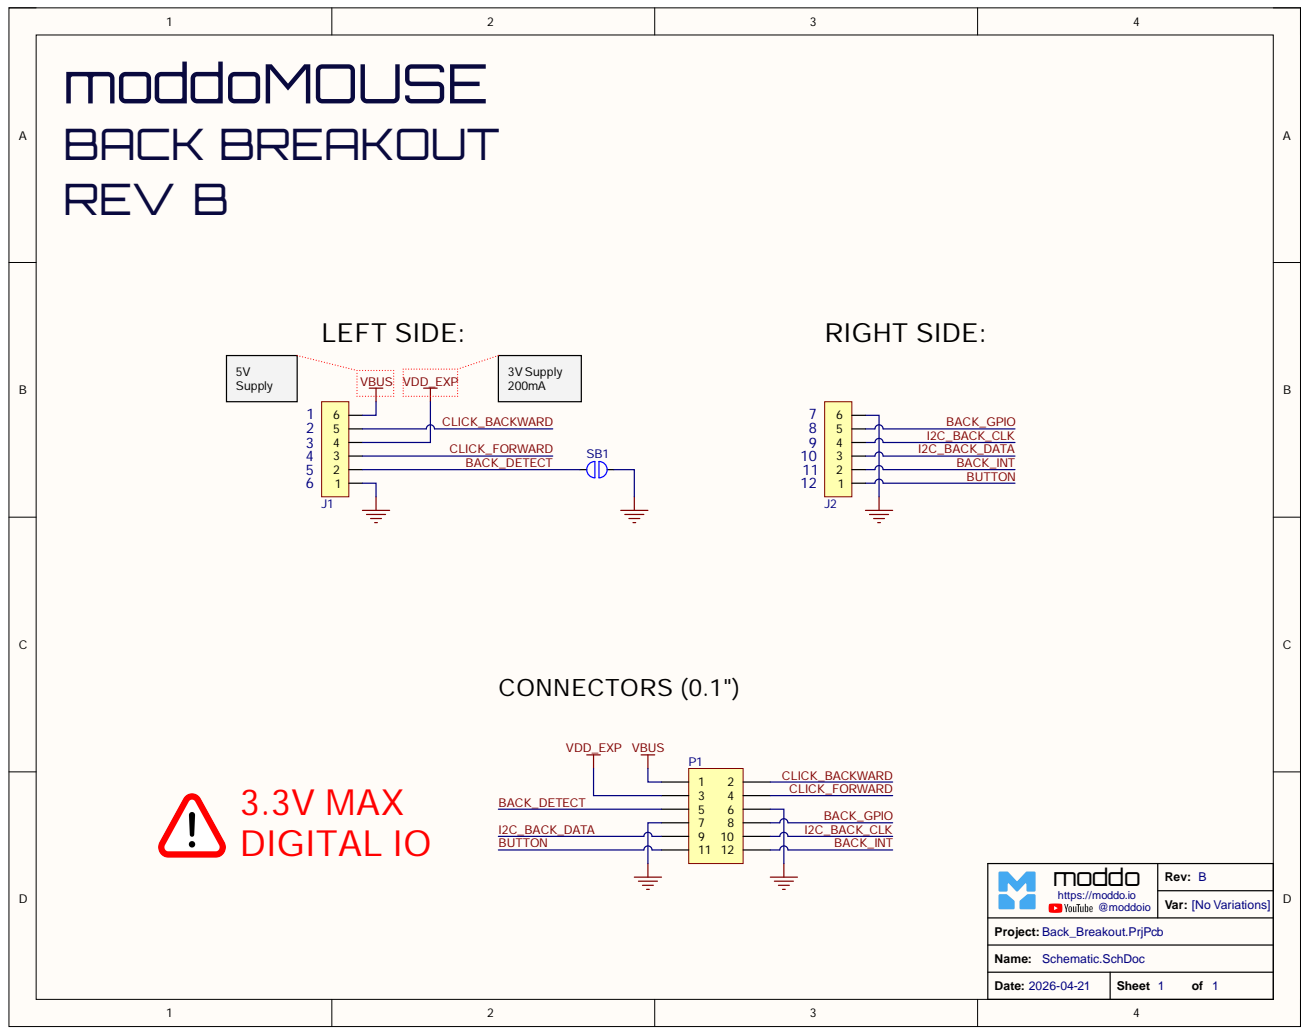
[picture p29: page 1]
