moddoio/moddoMOUSE-PCB/Back_Lite/Release/PCBA/01.SCHEMATICS/Schematics.PDF

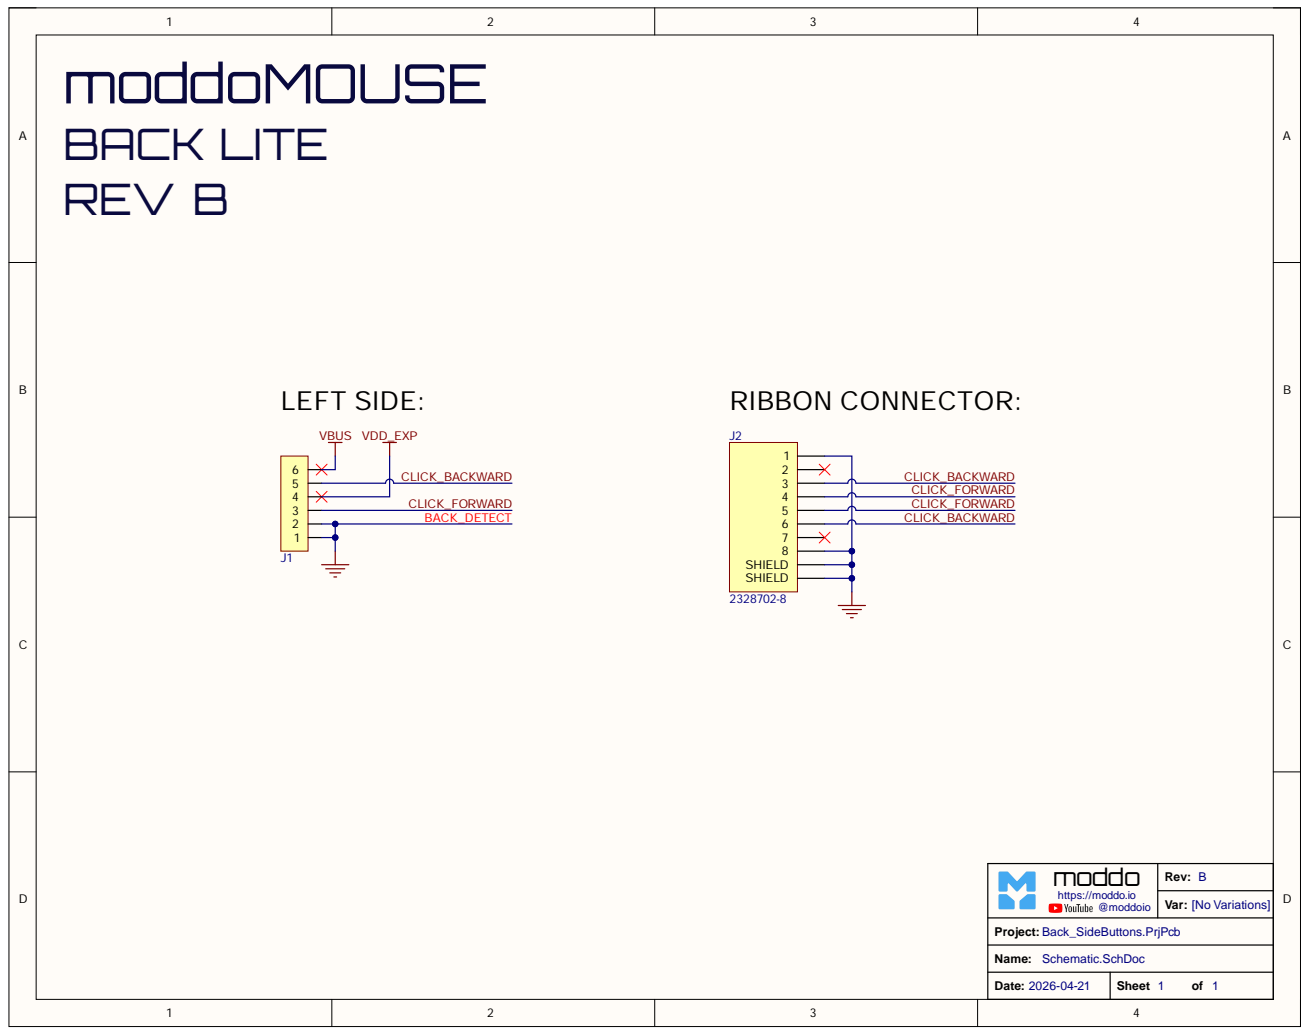
[picture p30: page 1]
