moddoio/moddoMOUSE-PCB/Front_Breakout/Release/PCBA/01.SCHEMATICS/Schematics.PDF

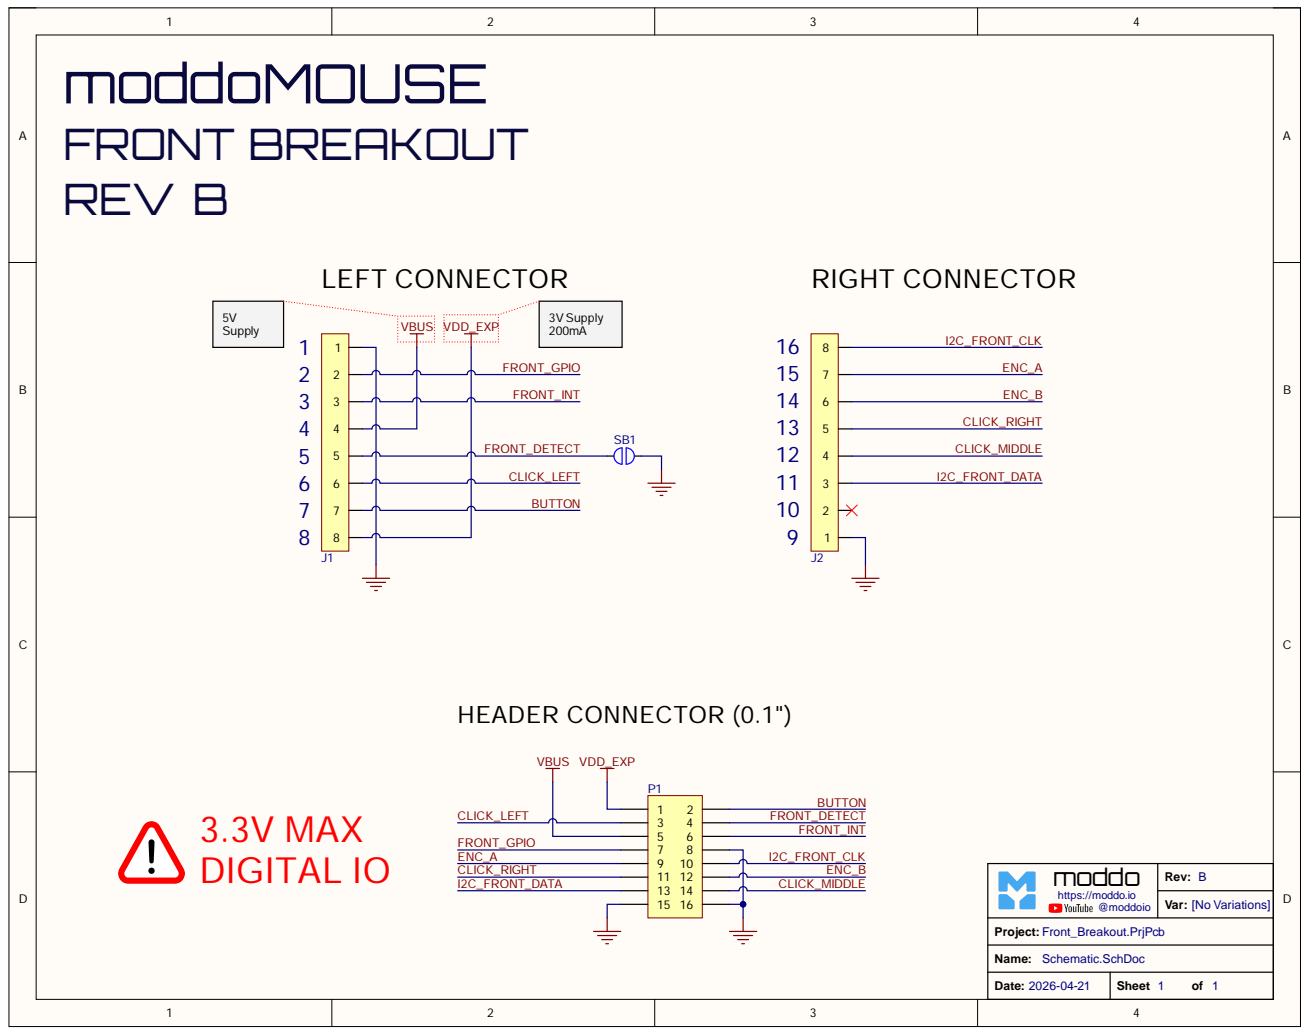
[picture p31: page 1]
