moddoio/moddoMOUSE-PCB/Front_Default/Release/PCBA/01.SCHEMATICS/Schematics.PDF

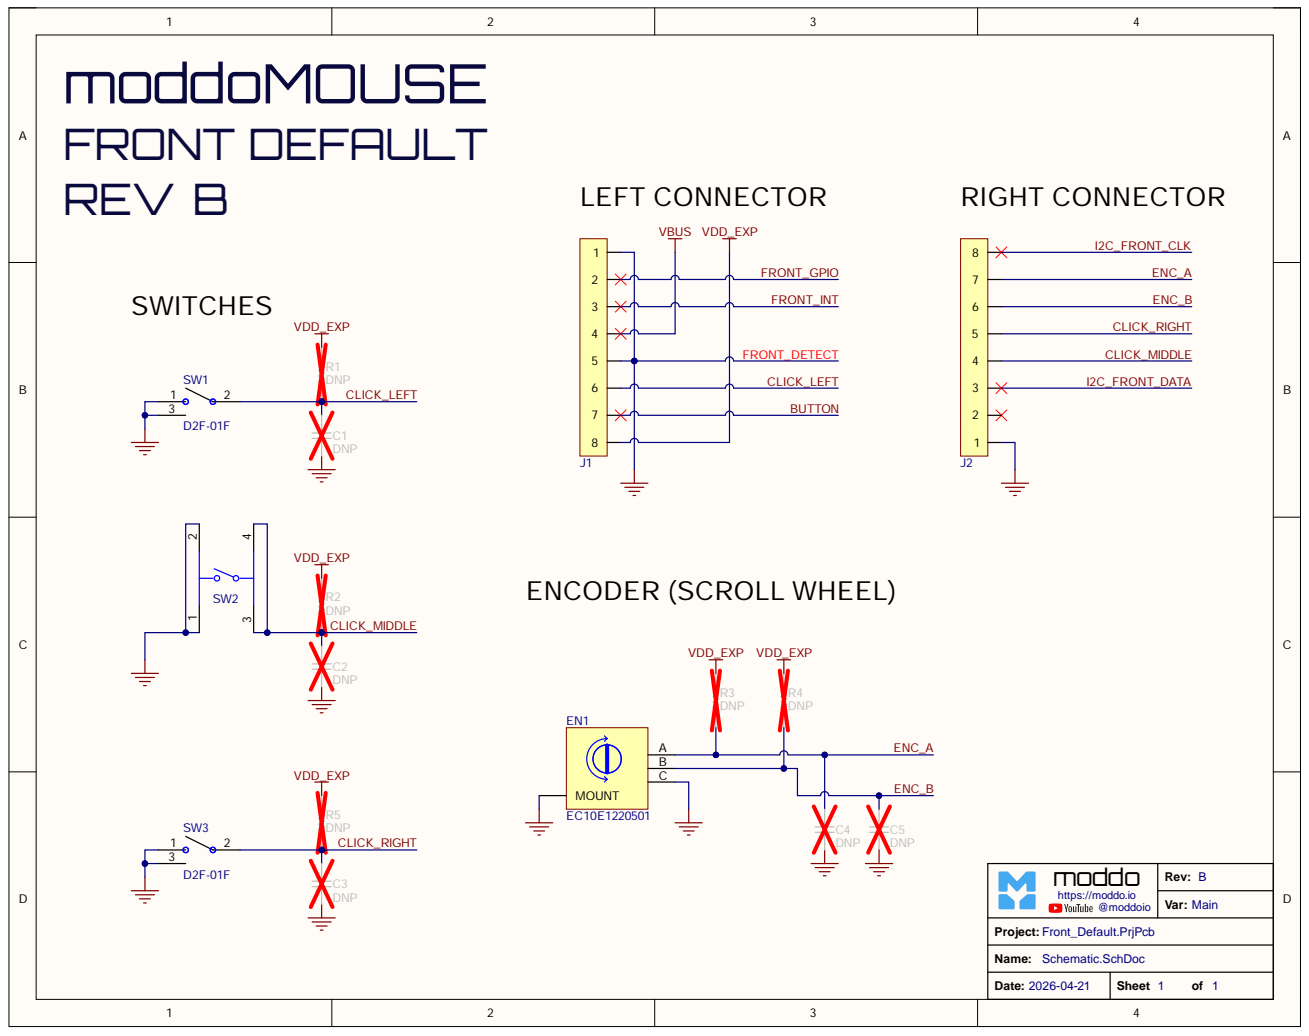
[picture p32: page 1]
