moddoio/moddoMOUSE-PCB/Side_Lite/Release/PCBA/01.SCHEMATICS/Schematics.PDF

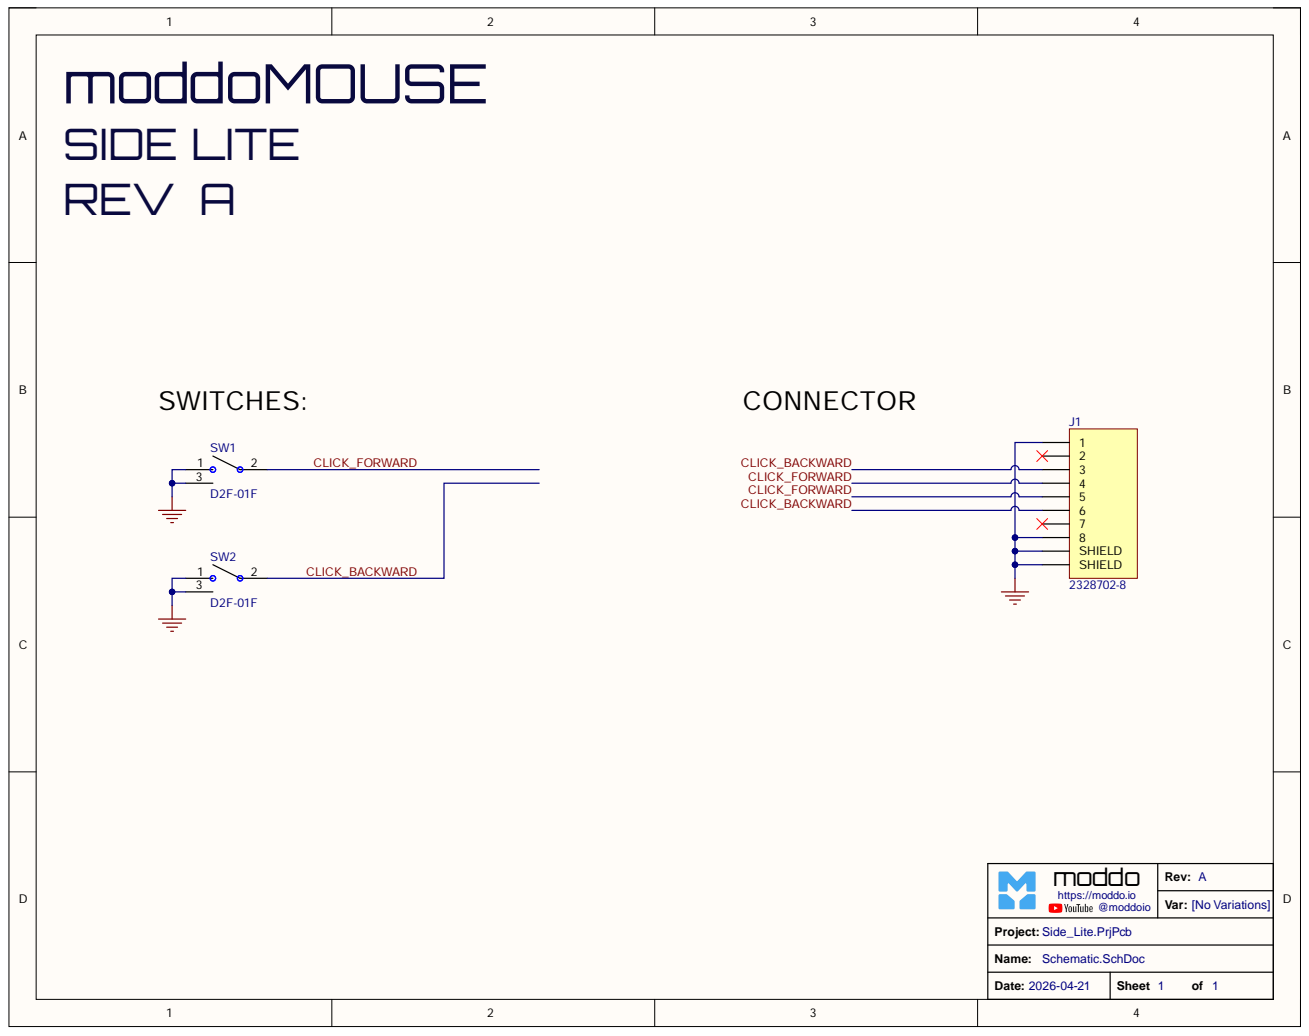
[picture p33: page 1]
