moddoio/moddoMOUSE-PCB/Back_Expansion/Back_Expansion_Base/Release/PCBA/01.SCHEMATICS/Schematics.PDF

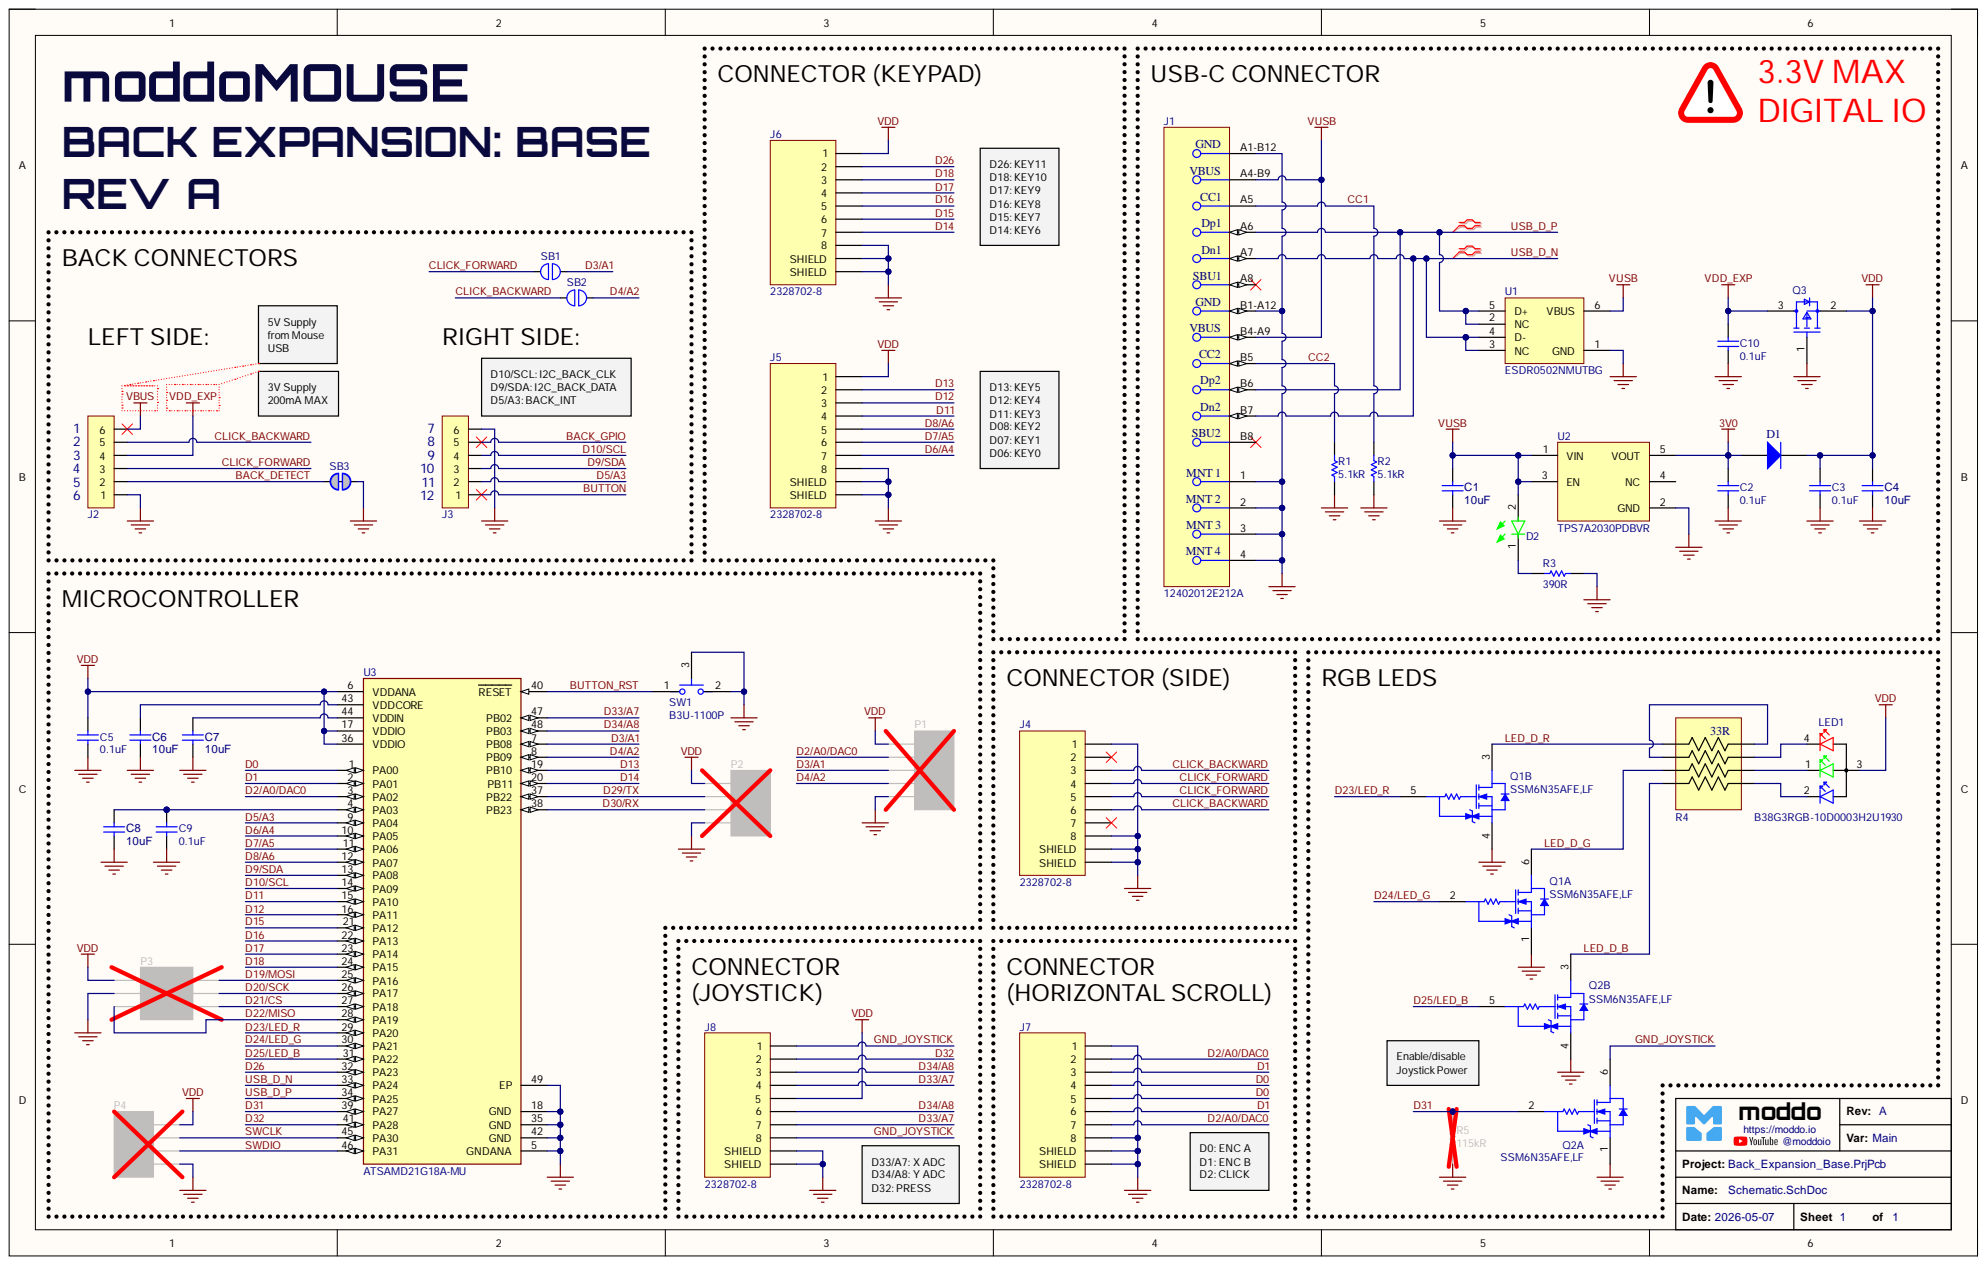
[picture p34: page 1]

D33/A 7 | D 0
D34/A 8 | D

modd o h t t p s : //mo d d o . i o @mo d d o i o | R e v : A
