moddoio/moddoMOUSE-PCB/Back_Expansion/Back_Expansion_Joystick_14p_25_5mm_20_3mm/Release/PCBA/01.SCHEMATICS/Schematics.PDF

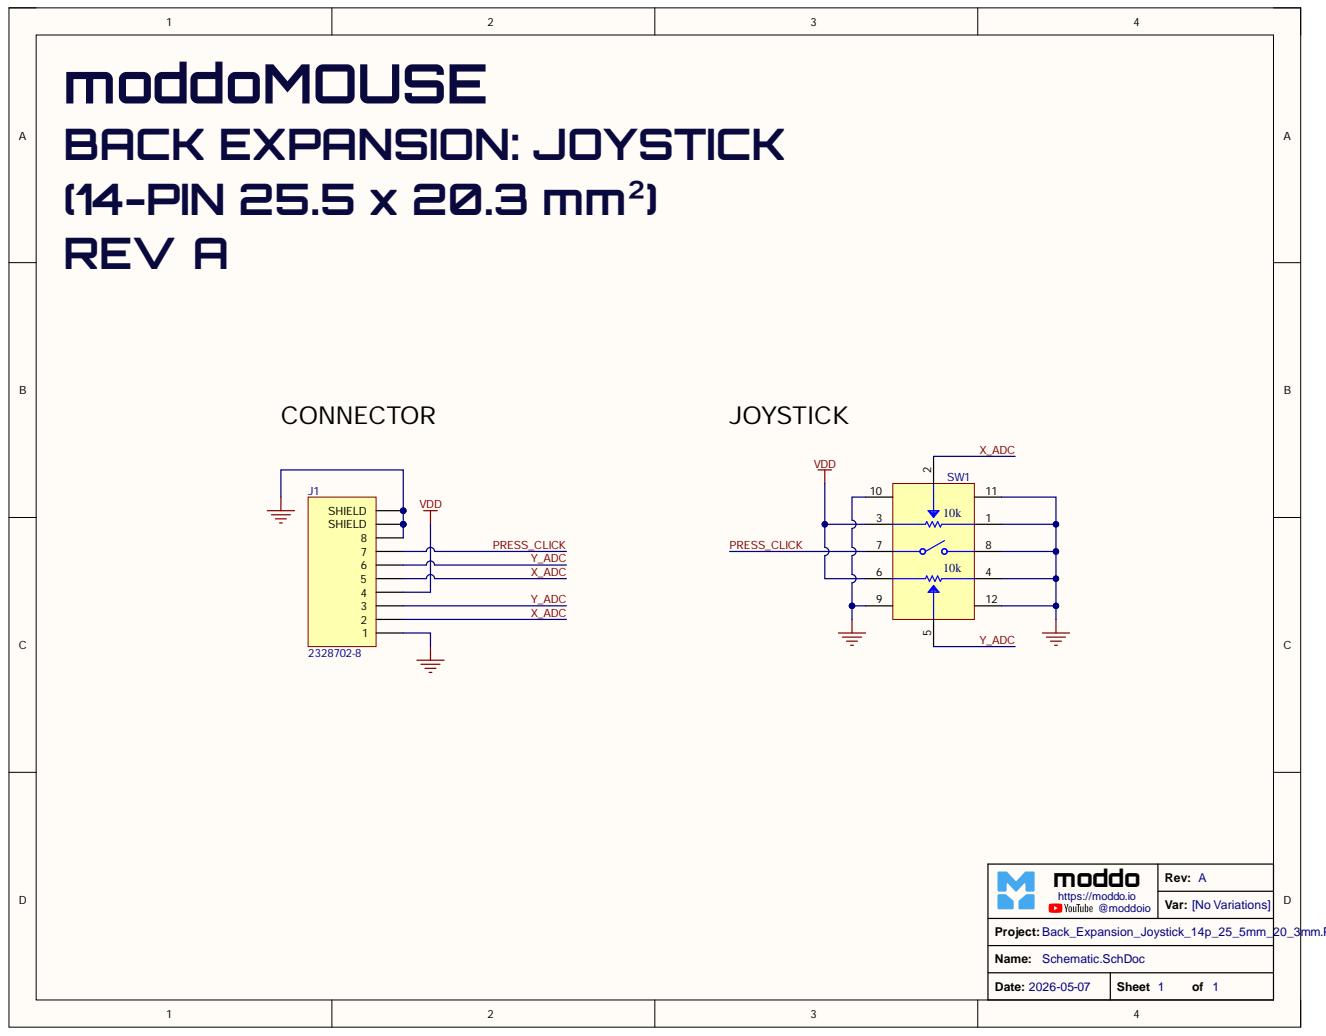
[picture p35: page 1]
