moddoio/moddoMOUSE-PCB/Back_Expansion/Back_Expansion_Joystick_8p_16_5mm_15_5mm/Release/PCBA/01.SCHEMATICS/Schematics.PDF

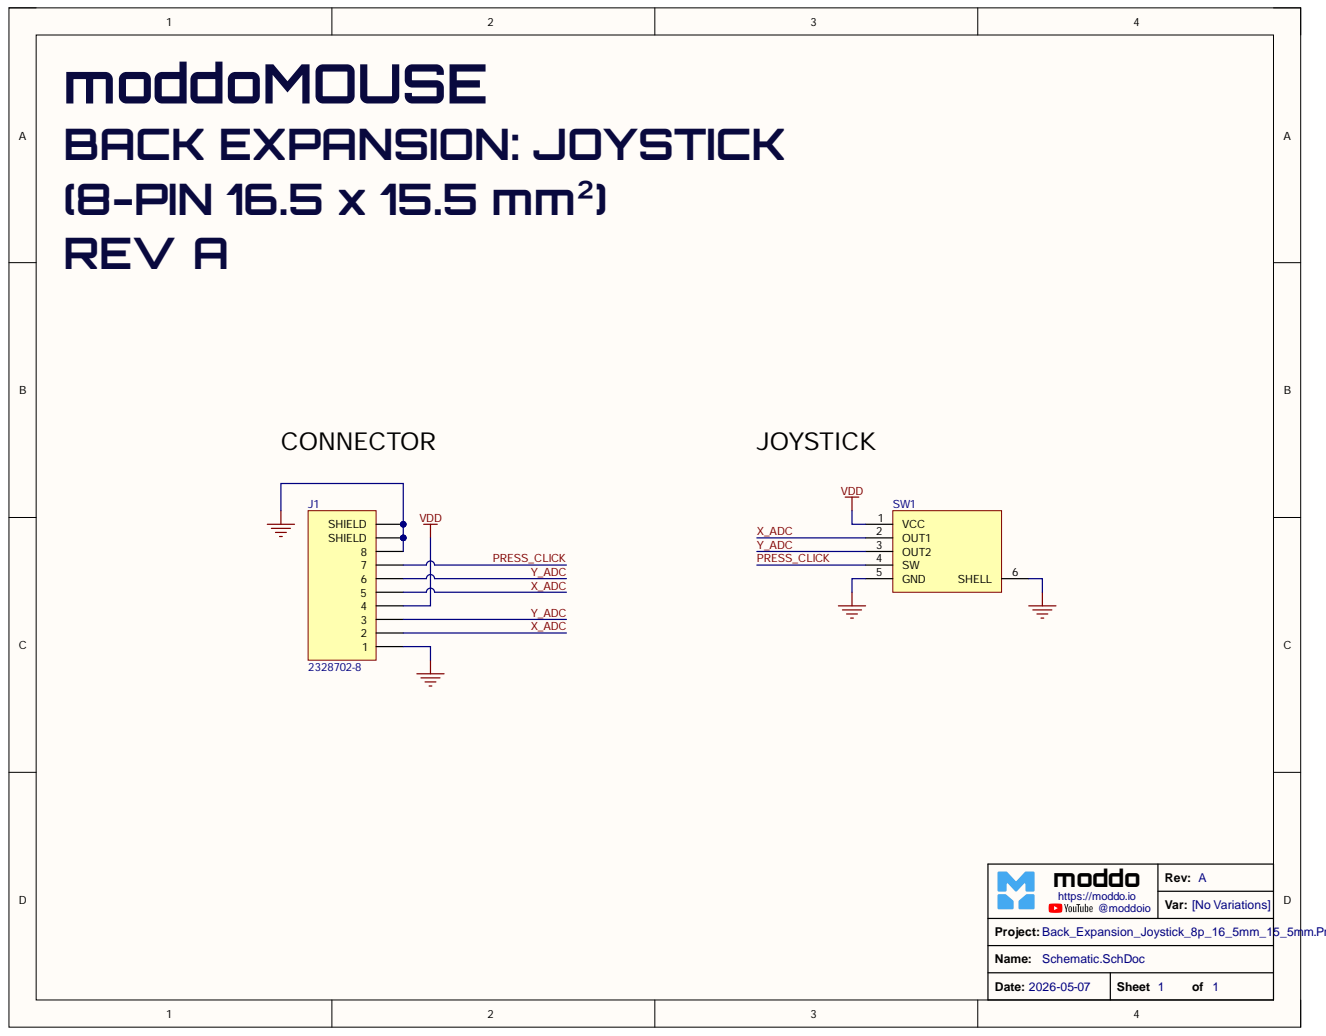
[picture p36: page 1]
