moddoio/moddoMOUSE-PCB/Back_Expansion/Back_Expansion_Keypad_12/Release/PCBA/01.SCHEMATICS/Schematics.PDF

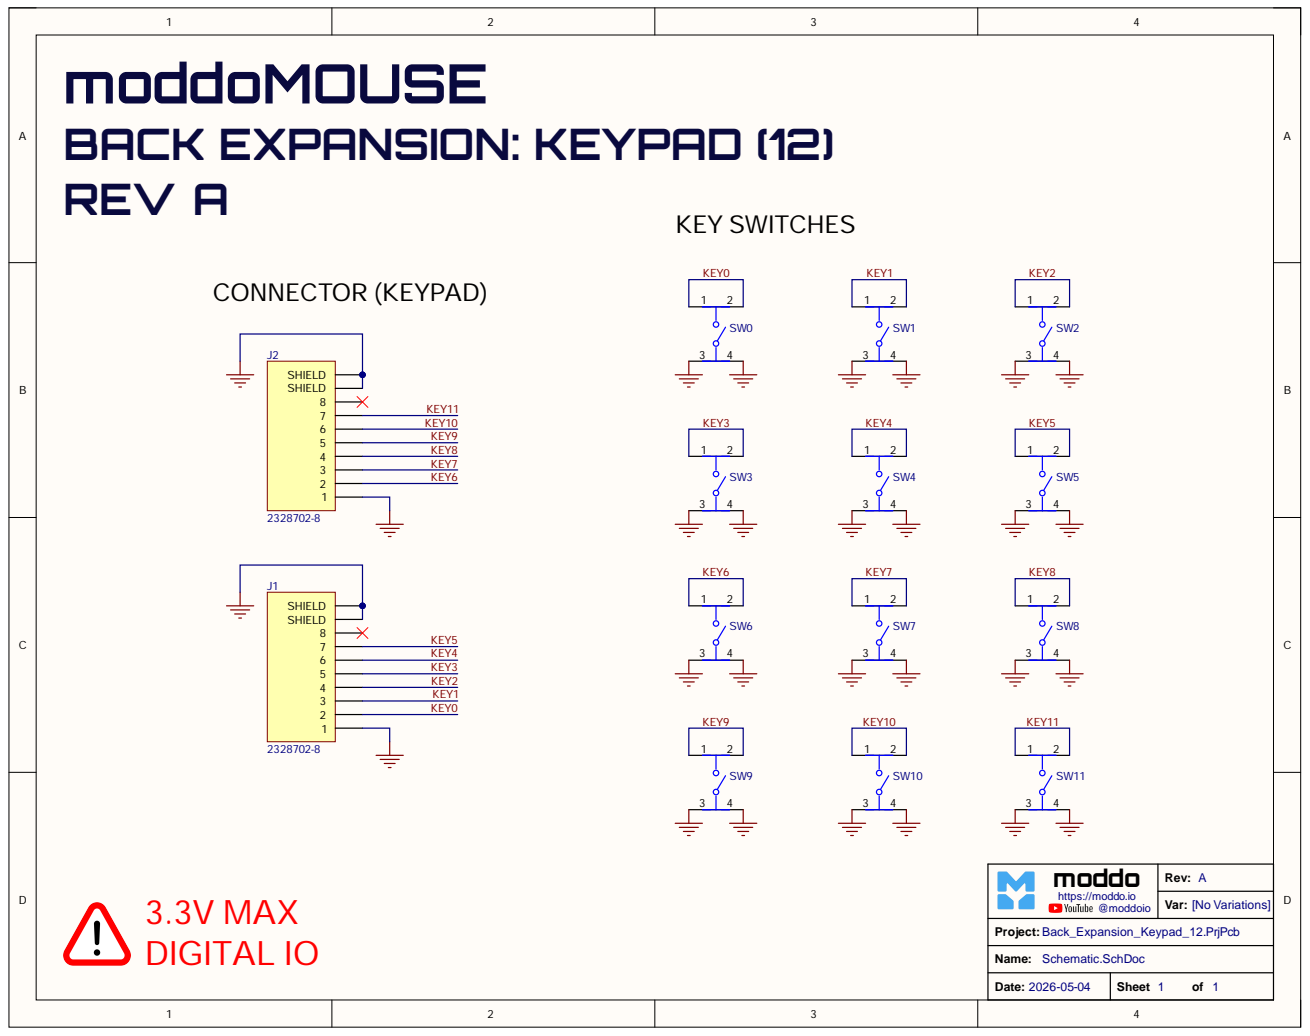
[picture p37: page 1]
