moddoio/moddoMOUSE-PCB/Back_Expansion/Back_Expansion_Keypad_6/Release/PCBA/01.SCHEMATICS/Schematics.PDF

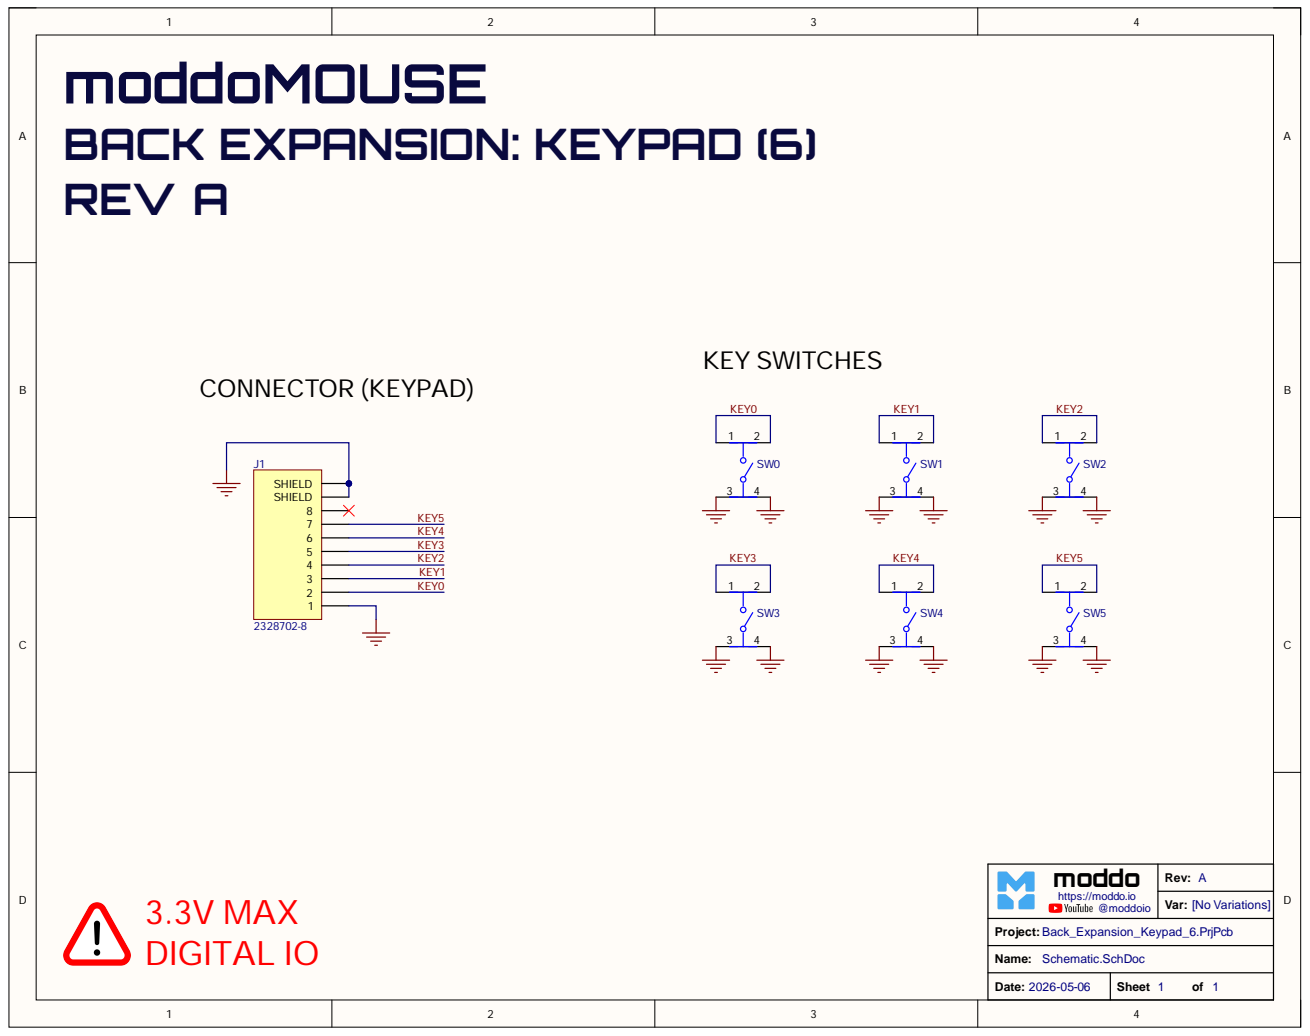
[picture p38: page 1]
