moddoio/moddoMOUSE-PCB/Back_Expansion/Back_Expansion_ScrollWheel/Release/PCBA/01.SCHEMATICS/Schematics.PDF

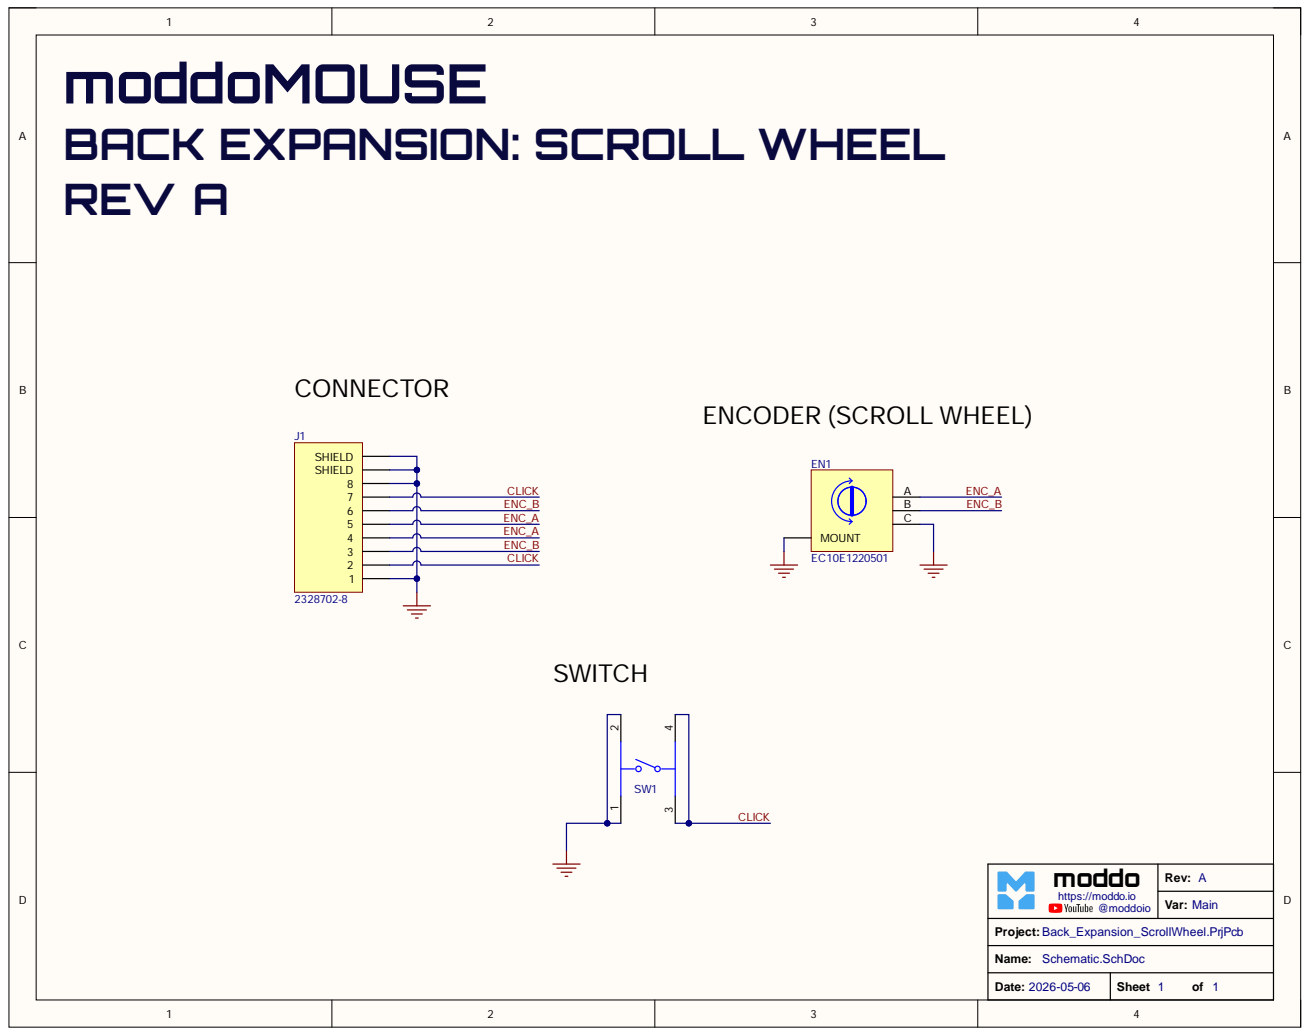
[picture p39: page 1]
