moddoio/moddoMOUSE-PCB/Front_Extended/Front_Extended_Front/Release/PCBA/01.SCHEMATICS/Schematics.PDF

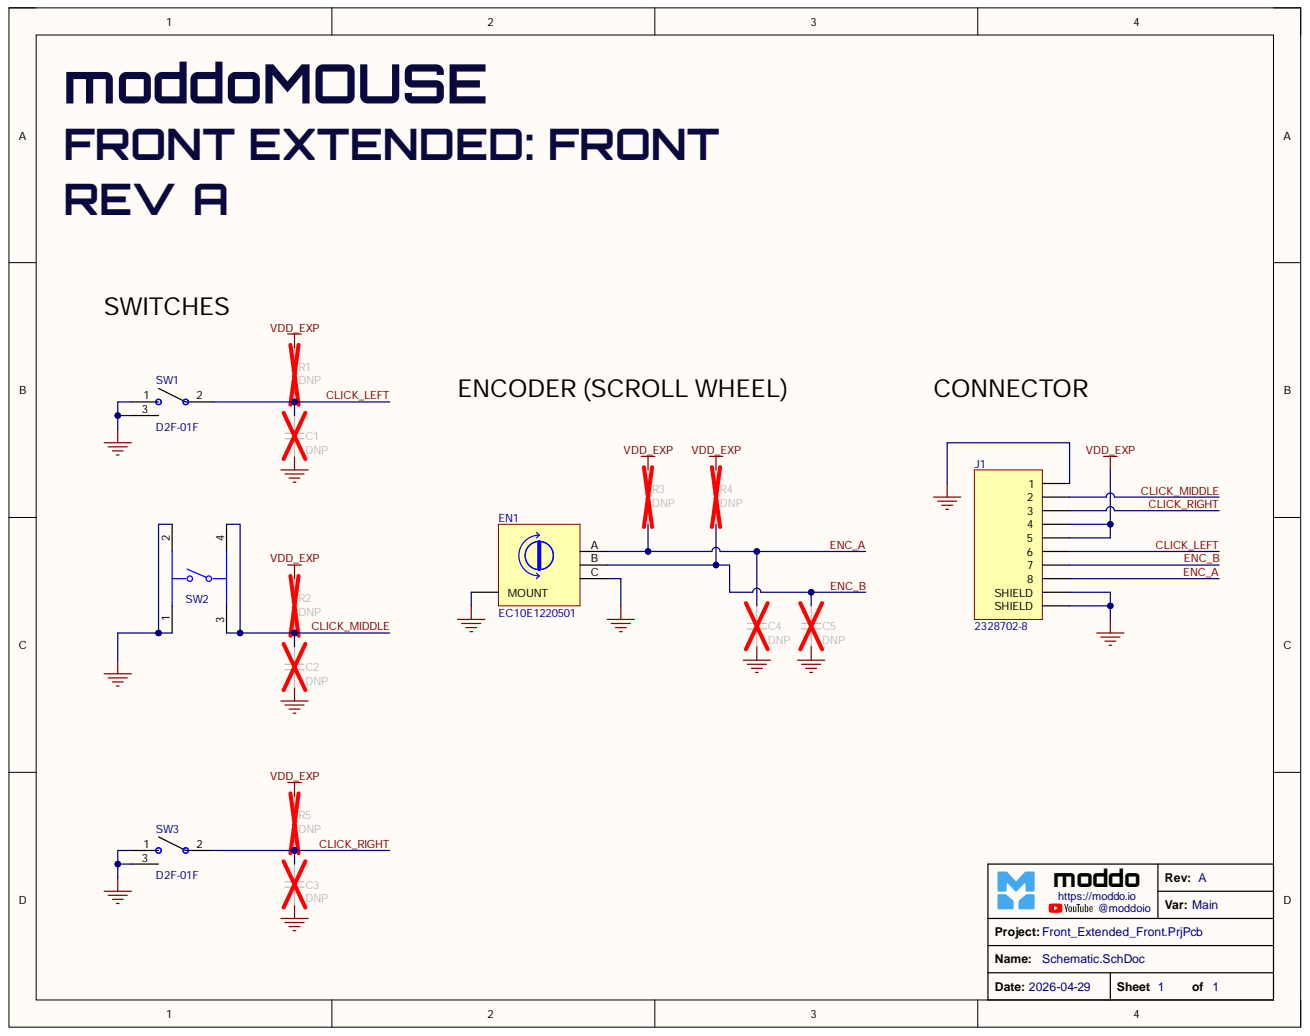
[picture p40: page 1]
