moddoio/moddoMOUSE-PCB/Front_Extended/Front_Extended_Base/Release/PCBA/01.SCHEMATICS/Schematics.PDF

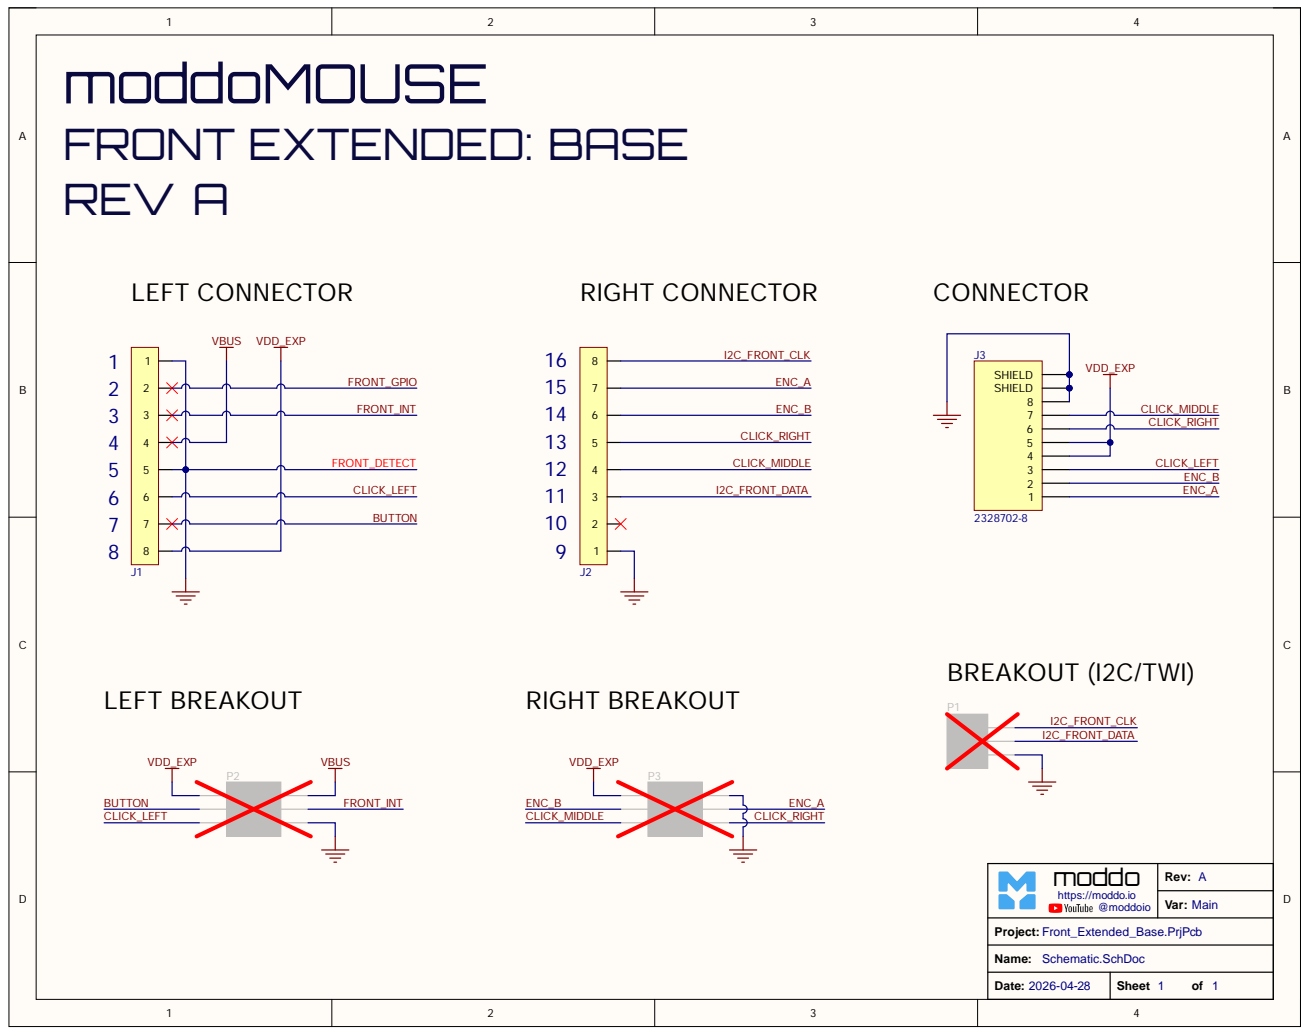
[picture p41: page 1]
