moddoio/moddoMOUSE-PCB/Front_Lite/Front_Lite_Left/Release/PCBA/01.SCHEMATICS/Schematics.PDF

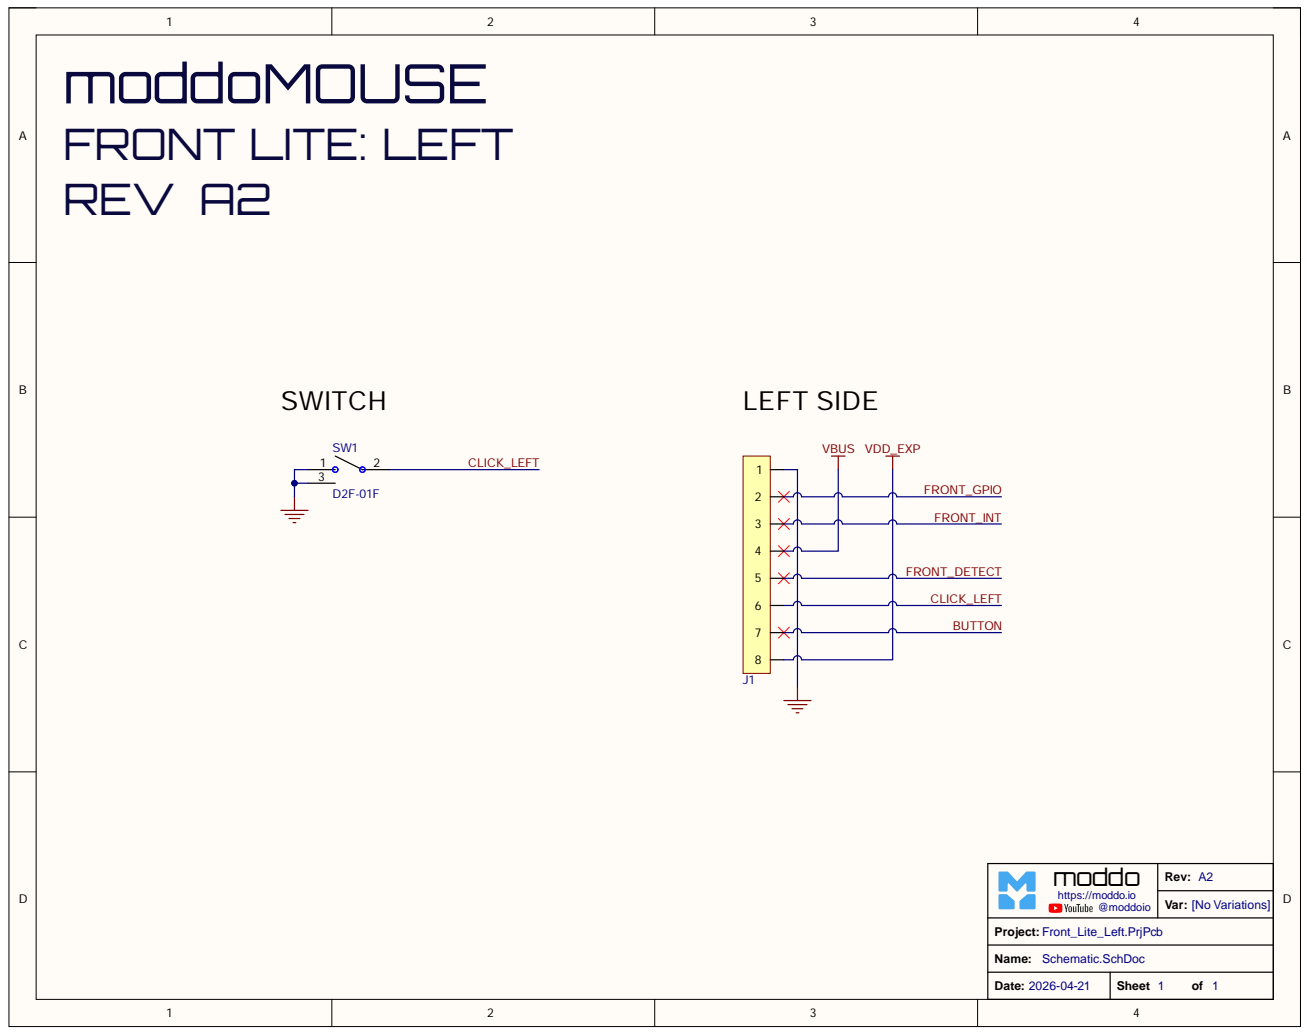
[picture p42: page 1]
