moddoio/moddoMOUSE-PCB/Front_Lite/Front_Lite_Right/Release/PCBA/01.SCHEMATICS/Schematics.PDF

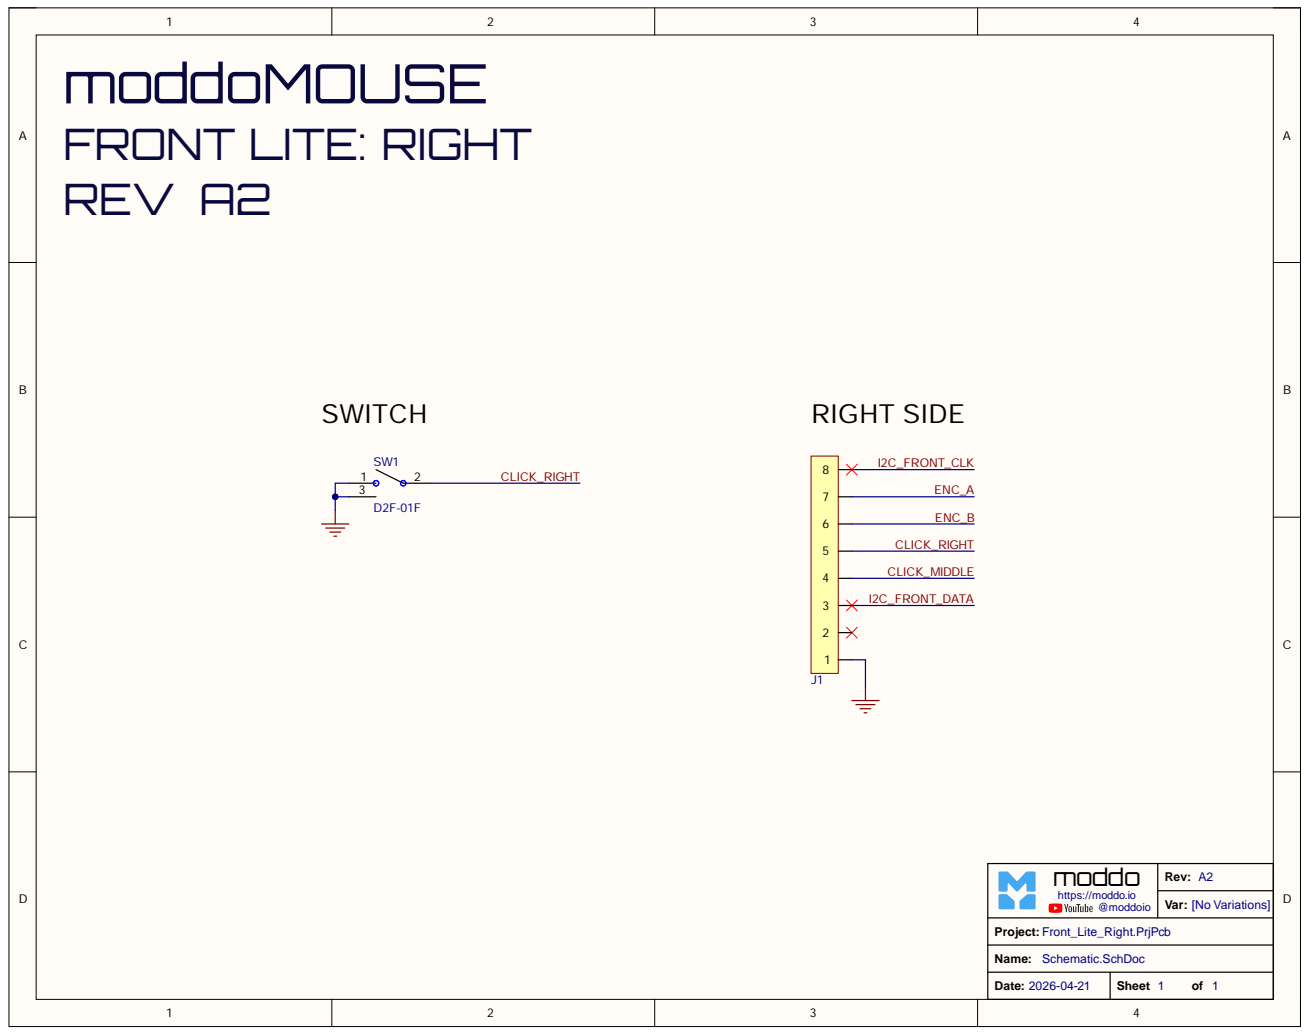
[picture p43: page 1]
