moddoio/moddoMOUSE-PCB/(list of files, drawings)

Other design files:
Back_Breakout/Back_Breakout.PrjPcb
Back_Breakout/Pcb/PCB.PcbDoc
Back_Breakout/Schematic/Schematic.SchDoc
Back_Expansion/Back_Expansion_Base/Back_Expansion_Base.PrjPcb
Back_Expansion/Back_Expansion_Base/Pcb/PCB.PcbDoc
Back_Expansion/Back_Expansion_Base/Pcb/PcbPanel.PcbDoc
Back_Expansion/Back_Expansion_Base/Schematic/Schematic.SchDoc
Back_Expansion/Back_Expansion_Breakout/Back_Expansion_Breakout.PrjPcb
Back_Expansion/Back_Expansion_Breakout/Pcb/PCB.PcbDoc
Back_Expansion/Back_Expansion_Breakout/Pcb/PcbPanel.PcbDoc
Back_Expansion/Back_Expansion_Breakout/Schematic/Schematic.SchDoc
Back_Expansion/Back_Expansion_Joystick_8p_16_5mm_15_5mm/Back_Expansion_Joystick_8p_16_5mm_15_5mm.PrjPcb
Back_Expansion/Back_Expansion_Joystick_8p_16_5mm_15_5mm/Pcb/PCB.PcbDoc
Back_Expansion/Back_Expansion_Joystick_8p_16_5mm_15_5mm/Pcb/PcbPanel.PcbDoc
Back_Expansion/Back_Expansion_Joystick_8p_16_5mm_15_5mm/Schematic/Schematic.SchDoc
Back_Expansion/Back_Expansion_Joystick_14p_25_5mm_20_3mm/Back_Expansion_Joystick_14p_25_5mm_20_3mm.PrjPcb
Back_Expansion/Back_Expansion_Joystick_14p_25_5mm_20_3mm/Pcb/PCB.PcbDoc
Back_Expansion/Back_Expansion_Joystick_14p_25_5mm_20_3mm/Pcb/PcbPanel.PcbDoc
Back_Expansion/Back_Expansion_Joystick_14p_25_5mm_20_3mm/Schematic/Schematic.SchDoc
Back_Expansion/Back_Expansion_Keypad_6/Back_Expansion_Keypad_6.PrjPcb
Back_Expansion/Back_Expansion_Keypad_6/Pcb/PCB.PcbDoc
Back_Expansion/Back_Expansion_Keypad_6/Pcb/PcbPanel.PcbDoc
Back_Expansion/Back_Expansion_Keypad_6/Schematic/Schematic.SchDoc
Back_Expansion/Back_Expansion_Keypad_12/Back_Expansion_Keypad_12.PrjPcb
Back_Expansion/Back_Expansion_Keypad_12/Pcb/PCB.PcbDoc
Back_Expansion/Back_Expansion_Keypad_12/Pcb/PcbPanel.PcbDoc
Back_Expansion/Back_Expansion_Keypad_12/Schematic/Schematic.SchDoc
Back_Expansion/Back_Expansion_ScrollWheel/Back_Expansion_ScrollWheel.PrjPcb
Back_Expansion/Back_Expansion_ScrollWheel/Pcb/PCB.PcbDoc
Back_Expansion/Back_Expansion_ScrollWheel/Pcb/PcbPanel.PcbDoc
Back_Expansion/Back_Expansion_ScrollWheel/Schematic/Schematic.SchDoc
Back_Lite/Back_Lite.PrjPcb
Back_Lite/Pcb/PCB.PcbDoc
Back_Lite/Pcb/PcbPanel.PcbDoc
Back_Lite/Schematic/Schematic.SchDoc
Front_Breakout/Front_Breakout.PrjPcb
Front_Breakout/Pcb/PCB.PcbDoc
Front_Breakout/Pcb/PcbPanel.PcbDoc
Front_Breakout/Schematic/Schematic.SchDoc
Front_Default/Front_Default.PrjPcb
Front_Default/Pcb/PCB.PcbDoc
Front_Default/Schematic/Schematic.SchDoc
Front_Extended/Front_Extended_Base/Front_Extended_Base.PrjPcb
Front_Extended/Front_Extended_Base/Pcb/PCB.PcbDoc
Front_Extended/Front_Extended_Base/Schematic/Schematic.SchDoc
Front_Extended/Front_Extended_Front/Front_Extended_Front.PrjPcb
Front_Extended/Front_Extended_Front/Pcb/PCB.PcbDoc
Front_Extended/Front_Extended_Front/Pcb/PcbPanel.PcbDoc
Front_Extended/Front_Extended_Front/Schematic/Schematic.SchDoc
Front_Lite/Front_Lite_Left/Front_Lite_Left.PrjPcb
Front_Lite/Front_Lite_Left/Pcb/PCB.PcbDoc
Front_Lite/Front_Lite_Left/Schematic/Schematic.SchDoc
Front_Lite/Front_Lite_Right/Front_Lite_Right.PrjPcb
Front_Lite/Front_Lite_Right/Pcb/PCB.PcbDoc
Front_Lite/Front_Lite_Right/Schematic/Schematic.SchDoc
Side_Lite/Pcb/PCB.PcbDoc
Side_Lite/Pcb/PcbPanel.PcbDoc
Side_Lite/Schematic/Schematic.SchDoc
Side_Lite/Side_Lite.PrjPcb
