moddoio/moddoMOUSE-PCB/(commit log)

2026-04-28 Added initial front extended PCBs
    [Bill_Of_Materials-BoM.xlsx, Front_Extended_Base.PrjPcb, Front_Extended_Front.PrjPcb, Front_Lite_Left.PrjPcb, Front_Lite_Right.PrjPcb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]
2026-04-28 Finalizing front extended layouts
    [Front_Extended_Base.PrjPcb, Front_Extended_Front.PrjPcb, PCB.PcbDoc]
2026-04-28 Completing release process for new PCBs
    [Bill_Of_Materials-BoM(Main).xlsx, Front_Extended_Base.PrjPcb, Front_Extended_Front.PrjPcb, PCB(Main).step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]
2026-04-28 WIP: Back Expansion Base schematic
    [Back_Expansion_Base.PrjPcb, Bill_Of_Materials-BoM.xlsx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]
2026-04-29 Changing encoder footprint
    [Bill_Of_Materials-BoM(Main).xlsx, Front_Extended_Front.PrjPcb, PCB(Main).step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]
2026-05-04 Completed Back Exp Board base
    [Back_Expansion_Base.PrjPcb, Bill_Of_Materials-BoM(Main).xlsx, Bill_Of_Materials-BoM.xlsx, PCB(Main).step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]
2026-05-05 Working on Keypad PCBs
    [Back_Expansion_Keypad_12.PrjPcb, Back_Expansion_Keypad_6.PrjPcb, Bill_Of_Materials-BoM.xlsx, Front_Extended_Base.PrjPcb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]
2026-05-06 WIP: keypad (6)
    [Back_Expansion_Keypad_6.PrjPcb, PCB.PcbDoc, Schematic.SchDoc]
2026-05-06 Added breakout PCB
    [Back_Expansion_Base.PrjPcb, Back_Expansion_Breakout.PrjPcb, Bill_Of_Materials-BoM(Main).xlsx, Bill_Of_Materials-BoM.xlsx, PCB(Main).step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]
2026-05-07 Added joystick PCBs
    [Back_Expansion_Joystick_14p_25_5mm_20_3mm.PrjPcb, Back_Expansion_Joystick_8p_16_5mm_15_5mm.PrjPcb, Back_Expansion_ScrollWheel.PrjPcb, Bill_Of_Materials-BoM(Main).xlsx, Bill_Of_Materials-BoM.xlsx, PCB(Main).step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]
2026-05-07 Adding in release files for Back Exp Board
    [Bill_Of_Materials-BoM(Main).xlsx, PCB(Main).step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]
